matthewlaujh/the-sun/kicad/layout-dxf/sun-assembly-with-mounts-preview.png

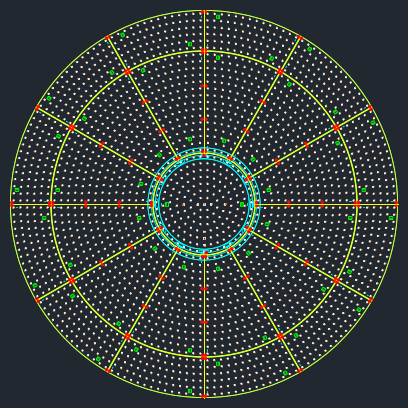
kicad/layout-dxf/sun-assembly-with-mounts-preview.png
