matthewlaujh/the-sun/sun-pcb-kicad-pack/docs/electrical-requirements.md

# Electrical requirements

Project: LED sun, Ø1773 mm disc · concentric rings, 12 wedges + centre disc · SK6812 RGBW @ 30 mm pitch · 2416 LEDs on 25 boards (3 unique designs) · PixLite E4-S Mk3.
Generated by Sun PCB Studio. Companion files: design.json (machine-readable), designs/*-outline.dxf, designs/*-placement.csv.

## System power

- 2416 × SK6812 RGBW @ 80 mA full white = **193 A @ 5 V (966 W)** worst case; typical content is far lower, but size for full white.
- PSU budget: ≥ 1160 W of 5 V supply (20 % headroom), e.g. 4× 300 W-class 5 V units, chassis-mounted behind the disc, short feeders.
- Distribution: one fused feeder per board power feed (blade fuse, rate ≈ 1.25× feed load, ≤ 10 A). 16 AWG per 10 A feeder max ~1 m.
- All GNDs common: PSU V− bus ↔ every board ↔ controller GND (PixLite outputs reference GND).

## Per-design current & copper (2-layer, 2 oz outer)

| Design | LEDs | Full-white | Feeds (≤10 A) | Min bus width per rail* |
|---|---|---|---|---|
| A | 172 | 13.8 A | 2 | 2.2 mm |
| B | 109 | 8.7 A | 1 | 1.2 mm |
| C | 78 | 6.2 A | 1 | 0.7 mm |

*IPC-2221 external, 10 °C rise, fed both ends. **Don't route power as traces — pour it**: V+ pour and GND pour covering the wire side (split roughly half/half or V+ pour + GND on LED side under the serpentine), stitched with vias at every LED. Wedge boards: run the pours as arcs following the LED rings; feed at the outer edge.

- Voltage-drop target: ≤ 0.15 V board-internal at full white (LEDs dim/redshift below ~4.5 V). With full-face pours this is comfortably met; verify worst path in the wedge tips.
- Data: 800 kHz single-ended; impedance uncontrolled. Keep LED-to-LED hops direct (serpentine per routing SVG), 100 Ω series at each board entry, pair with GND between boards.
- Frame budget: worst output chain 38.7 fps at 745 px/output cap (target 33.2).
- Thermal: 966 W over 2.5 m² is fine in open air at typical content; sustained full white pushes LED junctions — cap master brightness at ~60 % in the controller unless the show needs more.
