matthewlaujh/the-sun/sun-led-design-pack-test01/designs/design-C-drills.csv

Hole | Kind | Dia_mm | PosX_mm | PosY_mm | GlobalX_mm | GlobalY_mm
H1 | seam | 3.2 | -9.80 | 160.04 | 5.25 | 764.98
H2 | seam | 3.2 | 362.89 | 60.18 | 377.94 | 665.12
H3 | seam | 3.2 | 44.24 | 72.72 | 59.29 | 677.66
H4 | seam | 3.2 | 161.01 | 52.13 | 176.06 | 657.07
H5 | seam | 3.2 | 272.43 | 11.57 | 287.49 | 616.52
H6 | ring | 3.2 | 40.52 | 242.99 | 55.58 | 847.93
H7 | ring | 3.2 | 150.73 | 228.48 | 165.78 | 833.42
H8 | ring | 3.2 | 258.09 | 199.71 | 273.14 | 804.65
H9 | ring | 3.2 | 360.78 | 157.18 | 375.83 | 762.12
