matthewlaujh/the-sun/sun-pcb-kicad-pack/layout.png

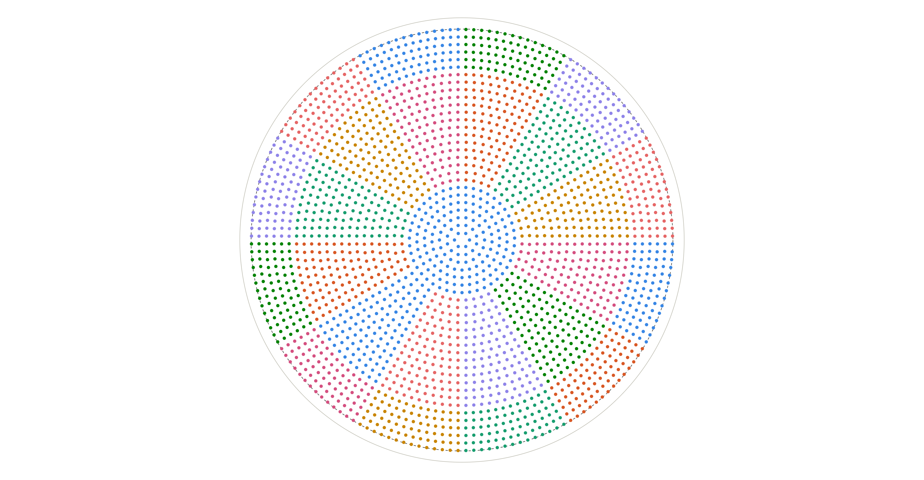
sun-pcb-kicad-pack/layout.png
