matthewlaujh/the-sun/sun-pcb-kicad-pack/docs/component-requirements.md

# Component requirements (BOM)

Project: LED sun, Ø1773 mm disc · concentric rings, 12 wedges + centre disc · SK6812 RGBW @ 30 mm pitch · 2416 LEDs on 25 boards (3 unique designs) · PixLite E4-S Mk3.
Generated by Sun PCB Studio. Companion files: design.json (machine-readable), designs/*-outline.dxf, designs/*-placement.csv.

## Per-design quantities (per single board)

| Design | Kind | Boards | LEDs | 100nF caps | R series | J_DIN+J_DOUT | Power feeds |
|---|---|---|---|---|---|---|---|
| A | disc | 1 | 172 | 172 | 1 | 1 | 2 |
| B | wedge | 12 | 109 | 109 | 1 | 1 | 1 |
| C | wedge | 12 | 78 | 78 | 1 | 1 | 1 |

## Line items

1. **LED — SK6812RGBW-NW (OPSCO)**, LCSC **C5160656**. RGBW 5050, natural-white W — pick -WW/-CW variant to taste and verify JLCPCB stock/loading fee. Total 2416 + ≥3 % reflow/rework spare → order ≈ 2500. Extended part (one-time loading fee per design).
2. **Vin cap — Samsung CL10B104KB8NNNC 100 nF 50 V X7R 0603**, LCSC **C1591** (JLCPCB basic part). Total 2416 + spare.
3. **Series data resistor** — 100 Ω 1 % 0603 (any basic part, e.g. LCSC C22775 class). 1 per board → 25.
4. **Data connectors** — JST XH 3-pin (B3B-XH-A top/side entry, THT, wire side) or JST SM pigtails; 2 per board (DIN+DOUT) → 50. THT = hand-solder or JLCPCB standard assembly only; SMD alternative: JST SM03B-SRSS-TB.
5. **Power feed hardware** — 26 feeds total: XT30PW-M right-angle (THT) or bare M4 ring-lug pad pairs (zero-cost option: plated pads + screw/nut). Bulk cap per feed: 470–1000 µF ≥ 6.3 V low-ESR (e.g. polymer). 26× cap.
6. **Distributed bulk** — 22–47 µF 6.3 V+ ceramic/polymer, ~1 per 30 LEDs → ≈ 81 total.

## Assembly notes (JLCPCB)

- Single-side SMT assembly (top = LED side): LEDs + 100 nF caps + series R. Wire-side parts (connectors, bulk caps) are THT/hand-solder — or flip to standard double-side assembly if you want them placed too.
- SK6812 RGBW is moisture-sensitive (MSL); JLCPCB bakes automatically — no action.
- Confirm the LED part's PCBA process (economic vs standard) on its JLCPCB page before committing the panel size.
- Mounting hardware: NONE on these boards by design (added in a later revision).
