matthewlaujh/the-sun/kicad/layout-dxf/sun-assembly-with-mounts.dxf

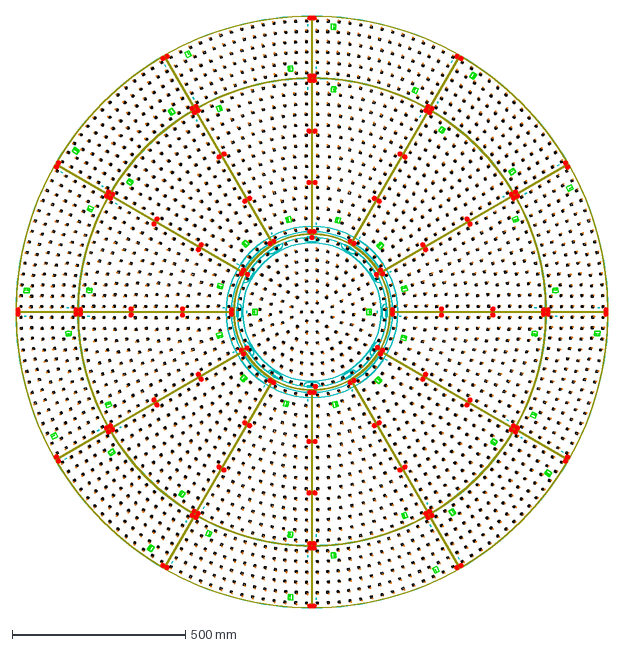
[picture p3: CAD file, 2026-09-03]
kicad/layout-dxf/sun-assembly-with-mounts.dxf
1708.0 x 1708.0 mm
