matthewlaujh/the-sun/kicad/layout-dxf/sun-assembly.dxf

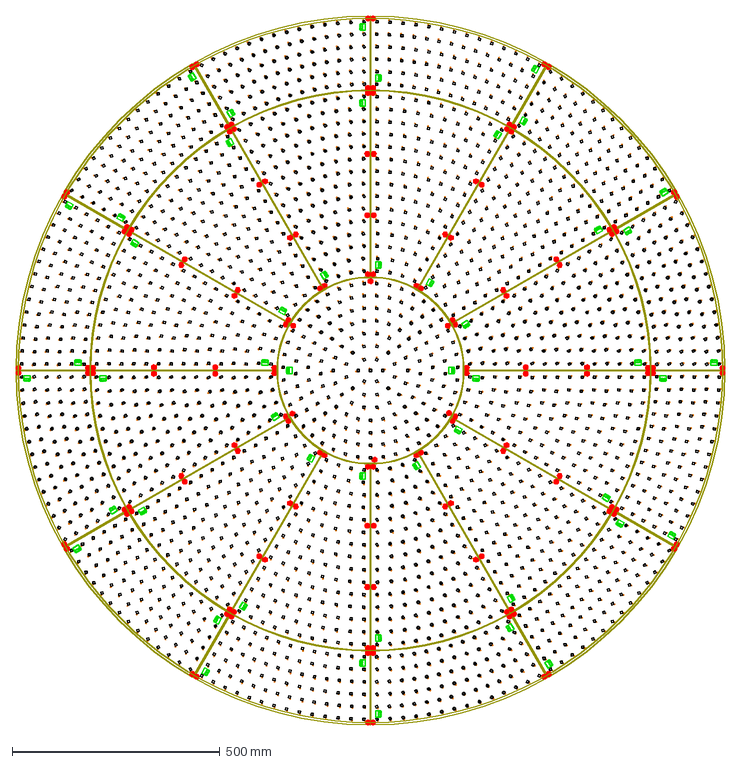
[picture p4: CAD file, 2026-09-03]
kicad/layout-dxf/sun-assembly.dxf
1708.0 x 1708.0 mm
