matthewlaujh/the-sun/sun-pcb-kicad-pack/designs/design-B-outline.dxf

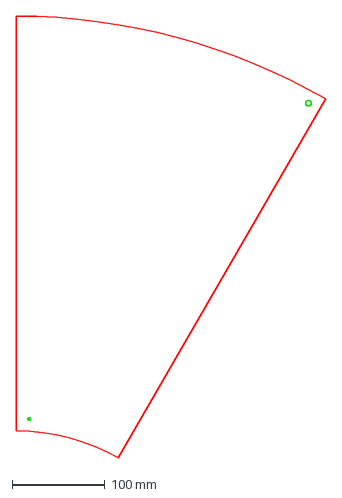
[picture p5: CAD file, 2026-08-16]
sun-pcb-kicad-pack/designs/design-B-outline.dxf
332.8 x 475.4 mm
