matthewlaujh/the-sun/sun-pcb-kicad-pack/designs/design-C-outline.dxf

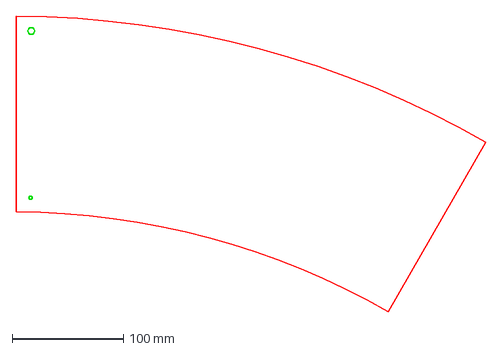
[picture p6: CAD file, 2026-08-16]
sun-pcb-kicad-pack/designs/design-C-outline.dxf
422.8 x 265.7 mm
