matthewlaujh/the-sun/sun-pcb-kicad-pack/designs/design-A-outline.dxf

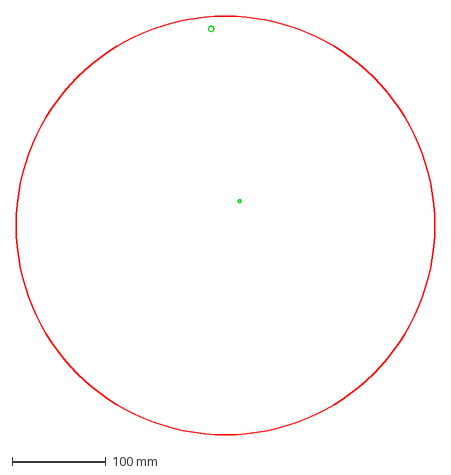
[picture p7: CAD file, 2026-08-16]
sun-pcb-kicad-pack/designs/design-A-outline.dxf
446.0 x 446.0 mm
