matthewlaujh/the-sun/(list of files, cad)

Other CAD files:
kicad/layout-dxf/sun-final-with-mounts.dxf
kicad/layout-dxf/sun-B-layout.dxf
kicad/layout-dxf/sun-C-layout.dxf
kicad/layout-dxf/sun-A-layout.dxf
