matthewlaujh/the-sun/kicad/layout-dxf/sun-assembly-preview.png

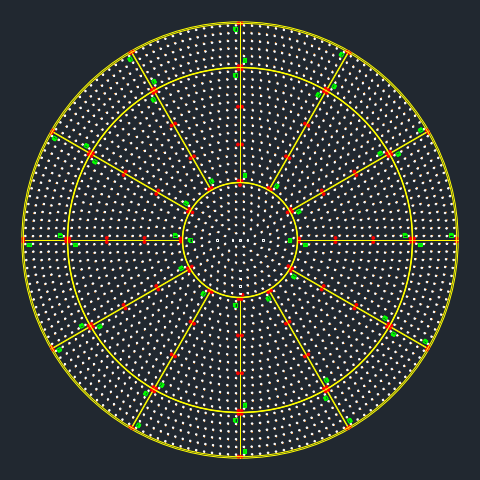
kicad/layout-dxf/sun-assembly-preview.png
