matthewlaujh/the-sun/sun-led-design-pack-test01/skeleton-members.csv

Member | Type | Role | Length_mm | x1_mm | y1_mm | x2_mm | y2_mm | Radius_mm | Start_deg | End_deg
1 | straight | under seam | 380.5 | -0.0 | 655.2 | -0.0 | 274.7
2 | straight | under seam | 380.5 | 0.0 | -274.7 | 0.0 | -655.2
3 | straight | under seam | 380.5 | 327.6 | 567.4 | 137.4 | 237.9
4 | straight | under seam | 380.5 | -137.4 | -237.9 | -327.6 | -567.4
5 | straight | under seam | 380.5 | 567.4 | 327.6 | 237.9 | 137.4
6 | straight | under seam | 380.5 | -237.9 | -137.4 | -567.4 | -327.6
7 | straight | under seam | 380.5 | 274.7 | 0.0 | 655.2 | 0.0
8 | straight | under seam | 380.5 | -567.4 | 327.6 | -237.9 | 137.4
9 | straight | under seam | 380.5 | 237.9 | -137.4 | 567.4 | -327.6
10 | straight | under seam | 380.5 | -327.6 | 567.4 | -137.4 | 237.9
11 | straight | under seam | 380.5 | 137.4 | -237.9 | 327.6 | -567.4
12 | straight | under seam | 380.5 | -274.7 | -0.0 | -655.2 | -0.0
13 | curved | under seam | 1107.8 |  |  |  |  | 764.0 | -151.16 | -68.08
14 | curved | under seam | 1107.8 |  |  |  |  | 764.0 | -68.08 | 15.00
15 | curved | under seam | 1107.8 |  |  |  |  | 764.0 | 15.00 | 98.08
16 | curved | under seam | 1107.8 |  |  |  |  | 764.0 | 98.08 | 181.16
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
