matthewlaujh/the-sun/sun-led-design-pack-test01/standoffs.csv

Standoff | Part | PCB | Design | Kind | x_mm | y_mm | Radius_mm | Angle_deg
1 | C2916368 | 13 | B | seam | -5.2 | 285.0 | 285.0 | 91.06
2 | C2916368 | 2 | B | seam | 5.2 | 285.0 | 285.0 | 88.94
3 | C2916368 | 2 | B | seam | 137.9 | 249.4 | 285.0 | 61.06
4 | C2916368 | 3 | B | seam | 147.0 | 244.2 | 285.0 | 58.94
5 | C2916368 | 3 | B | seam | 244.2 | 147.0 | 285.0 | 31.06
6 | C2916368 | 4 | B | seam | 249.4 | 137.9 | 285.0 | 28.94
7 | C2916368 | 4 | B | seam | 285.0 | 5.2 | 285.0 | 1.06
8 | C2916368 | 5 | B | seam | 285.0 | -5.2 | 285.0 | -1.06
9 | C2916368 | 5 | B | seam | 249.4 | -137.9 | 285.0 | -28.94
10 | C2916368 | 6 | B | seam | 244.2 | -147.0 | 285.0 | -31.06
11 | C2916368 | 6 | B | seam | 147.0 | -244.2 | 285.0 | -58.94
12 | C2916368 | 7 | B | seam | 137.9 | -249.4 | 285.0 | -61.06
13 | C2916368 | 7 | B | seam | 5.2 | -285.0 | 285.0 | -88.94
14 | C2916368 | 8 | B | seam | -5.2 | -285.0 | 285.0 | -91.06
15 | C2916368 | 8 | B | seam | -137.9 | -249.4 | 285.0 | -118.94
16 | C2916368 | 9 | B | seam | -147.0 | -244.2 | 285.0 | -121.06
17 | C2916368 | 9 | B | seam | -244.2 | -147.0 | 285.0 | -148.94
18 | C2916368 | 10 | B | seam | -249.4 | -137.9 | 285.0 | -151.06
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
