matthewlaujh/the-sun/sun-led-design-pack-test01/layout.png

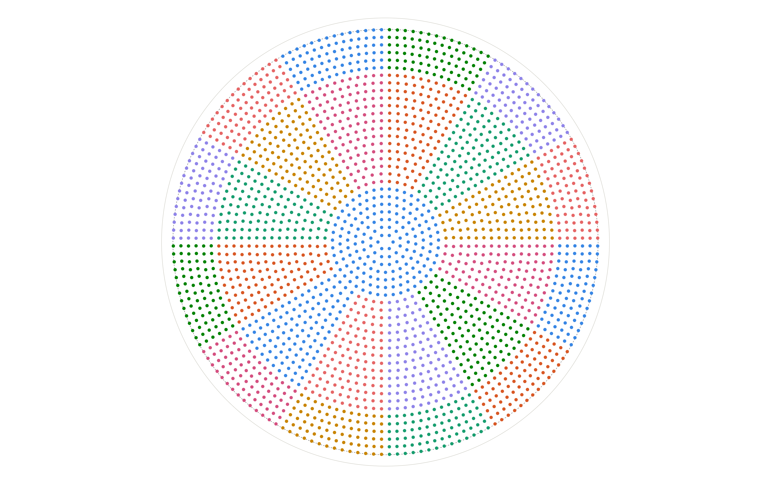
sun-led-design-pack-test01/layout.png
