matthewlaujh/the-sun/kicad/sun-A/sun-A.kicad_pcb

## KiCad design kicad/sun-A/sun-A.kicad_pcb (2026-10-01)

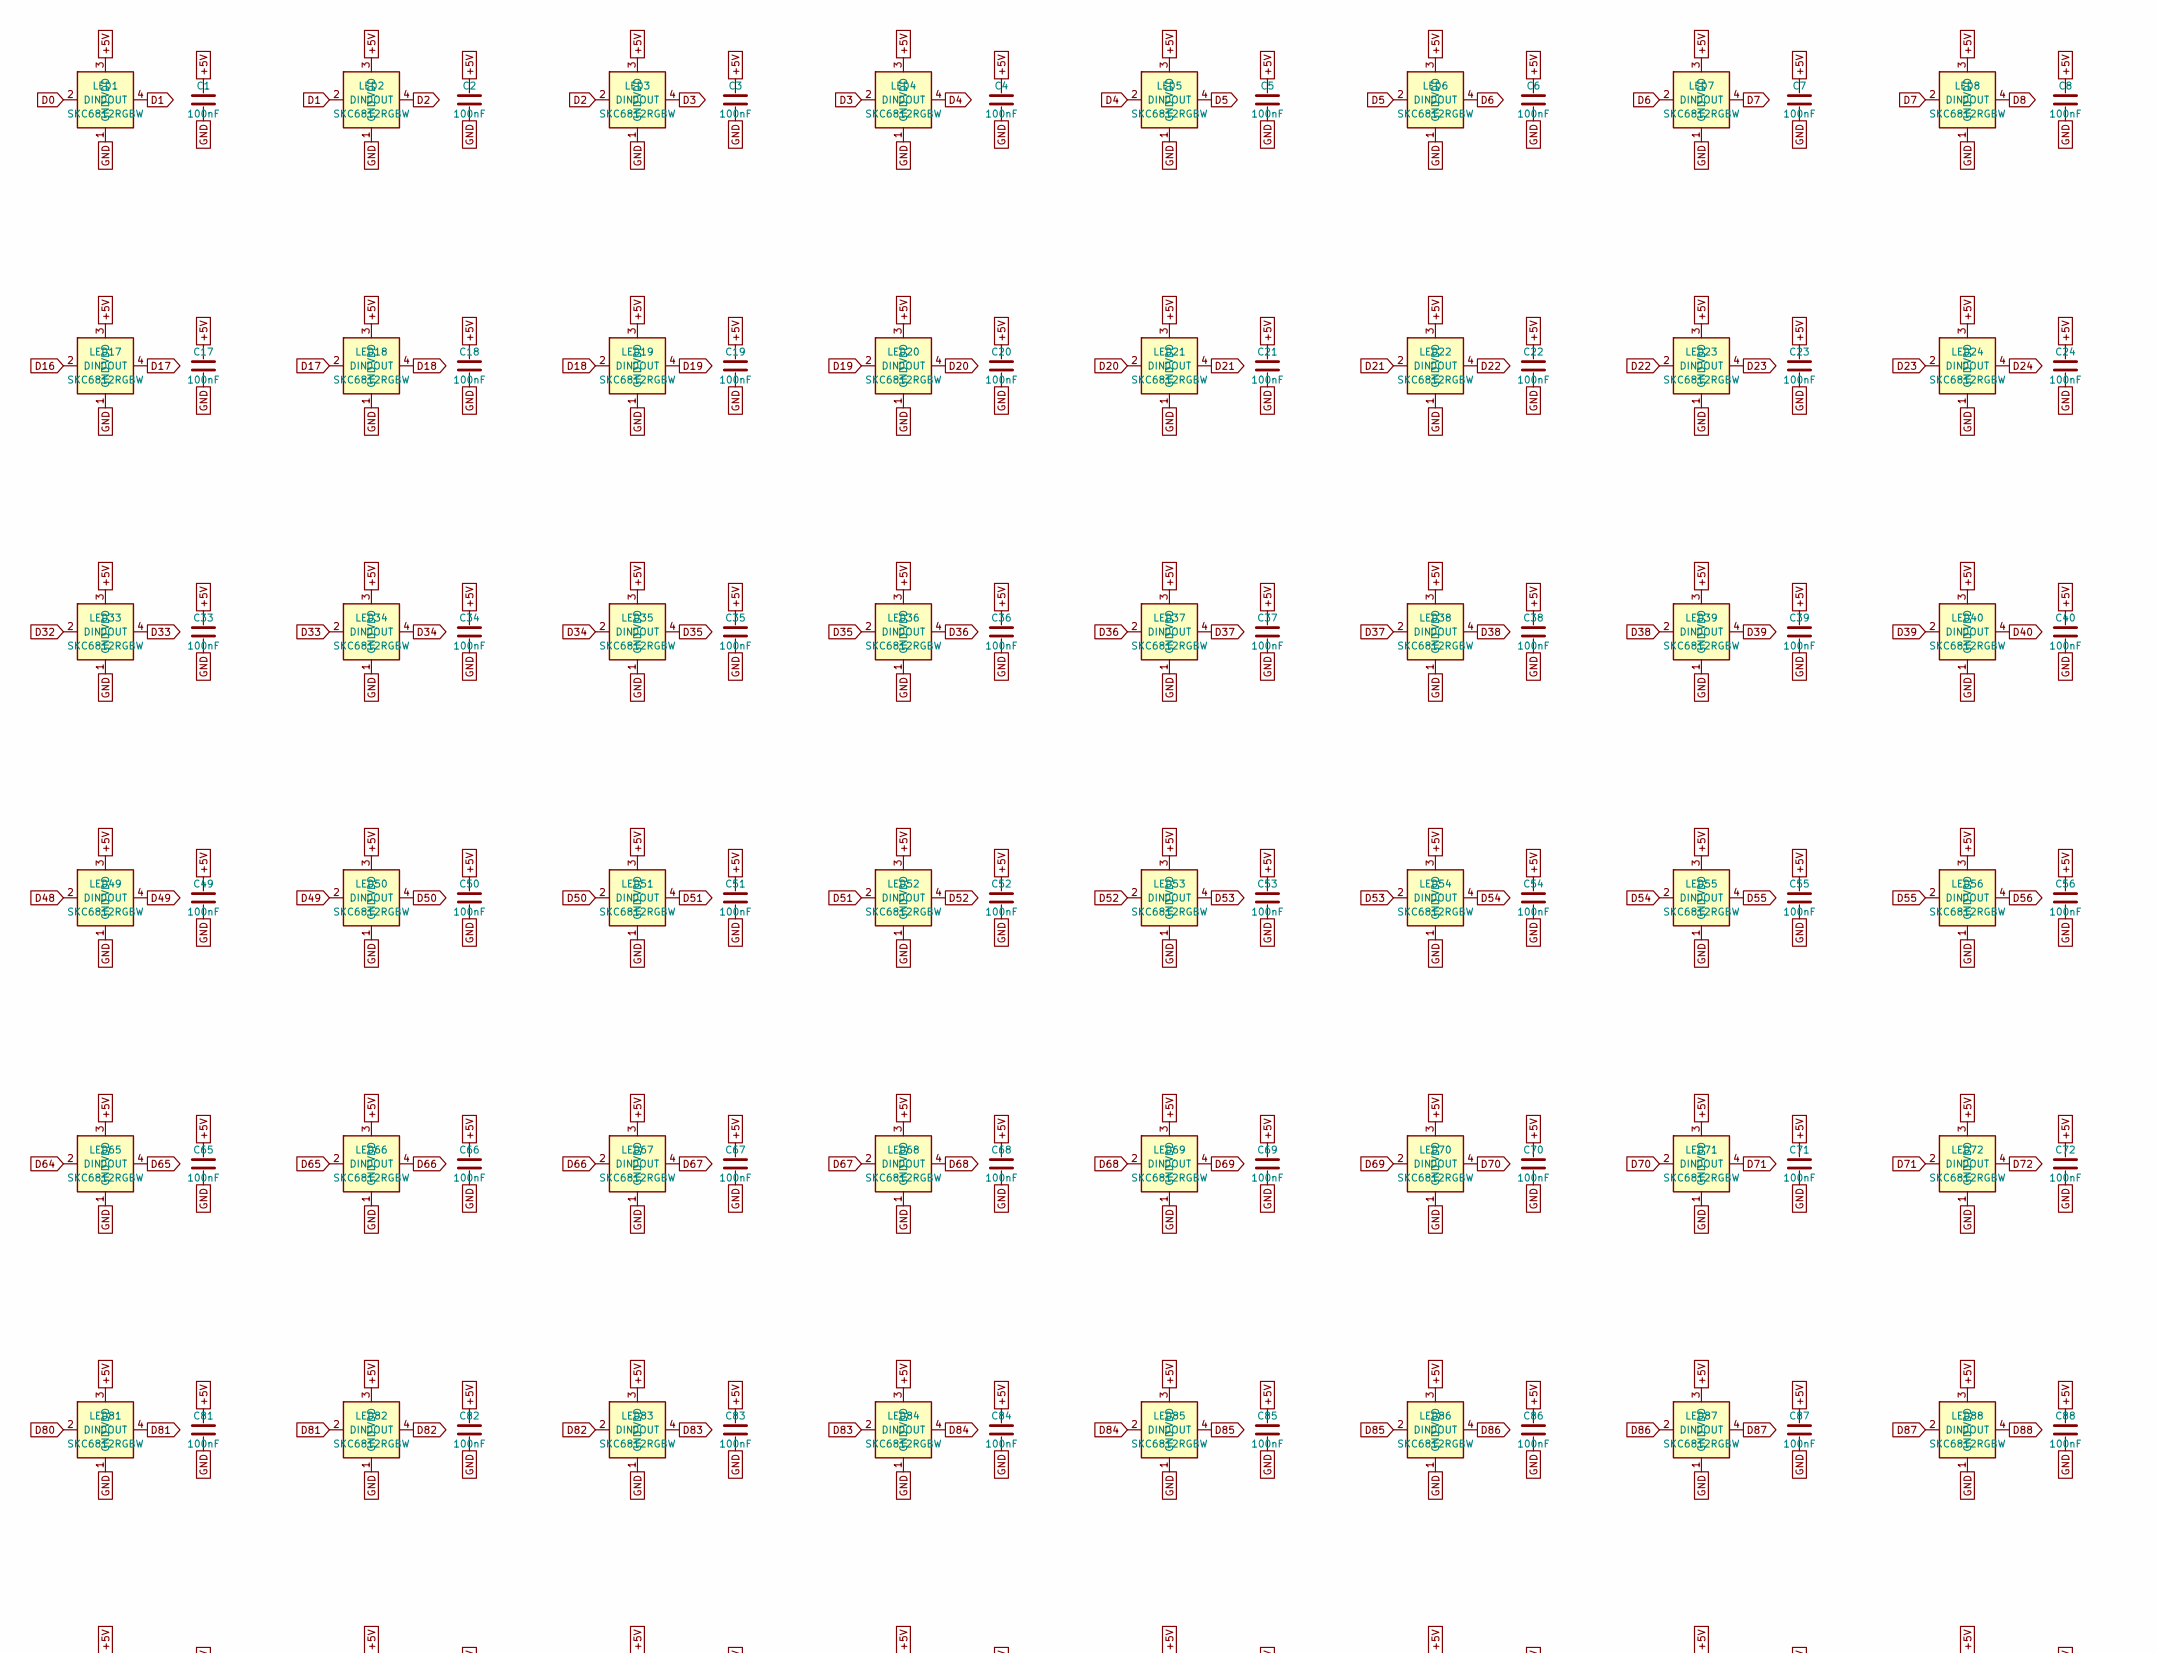
[picture p10: schematic sun-A.kicad_sch, the sun - design A, part in row 1, column 1]

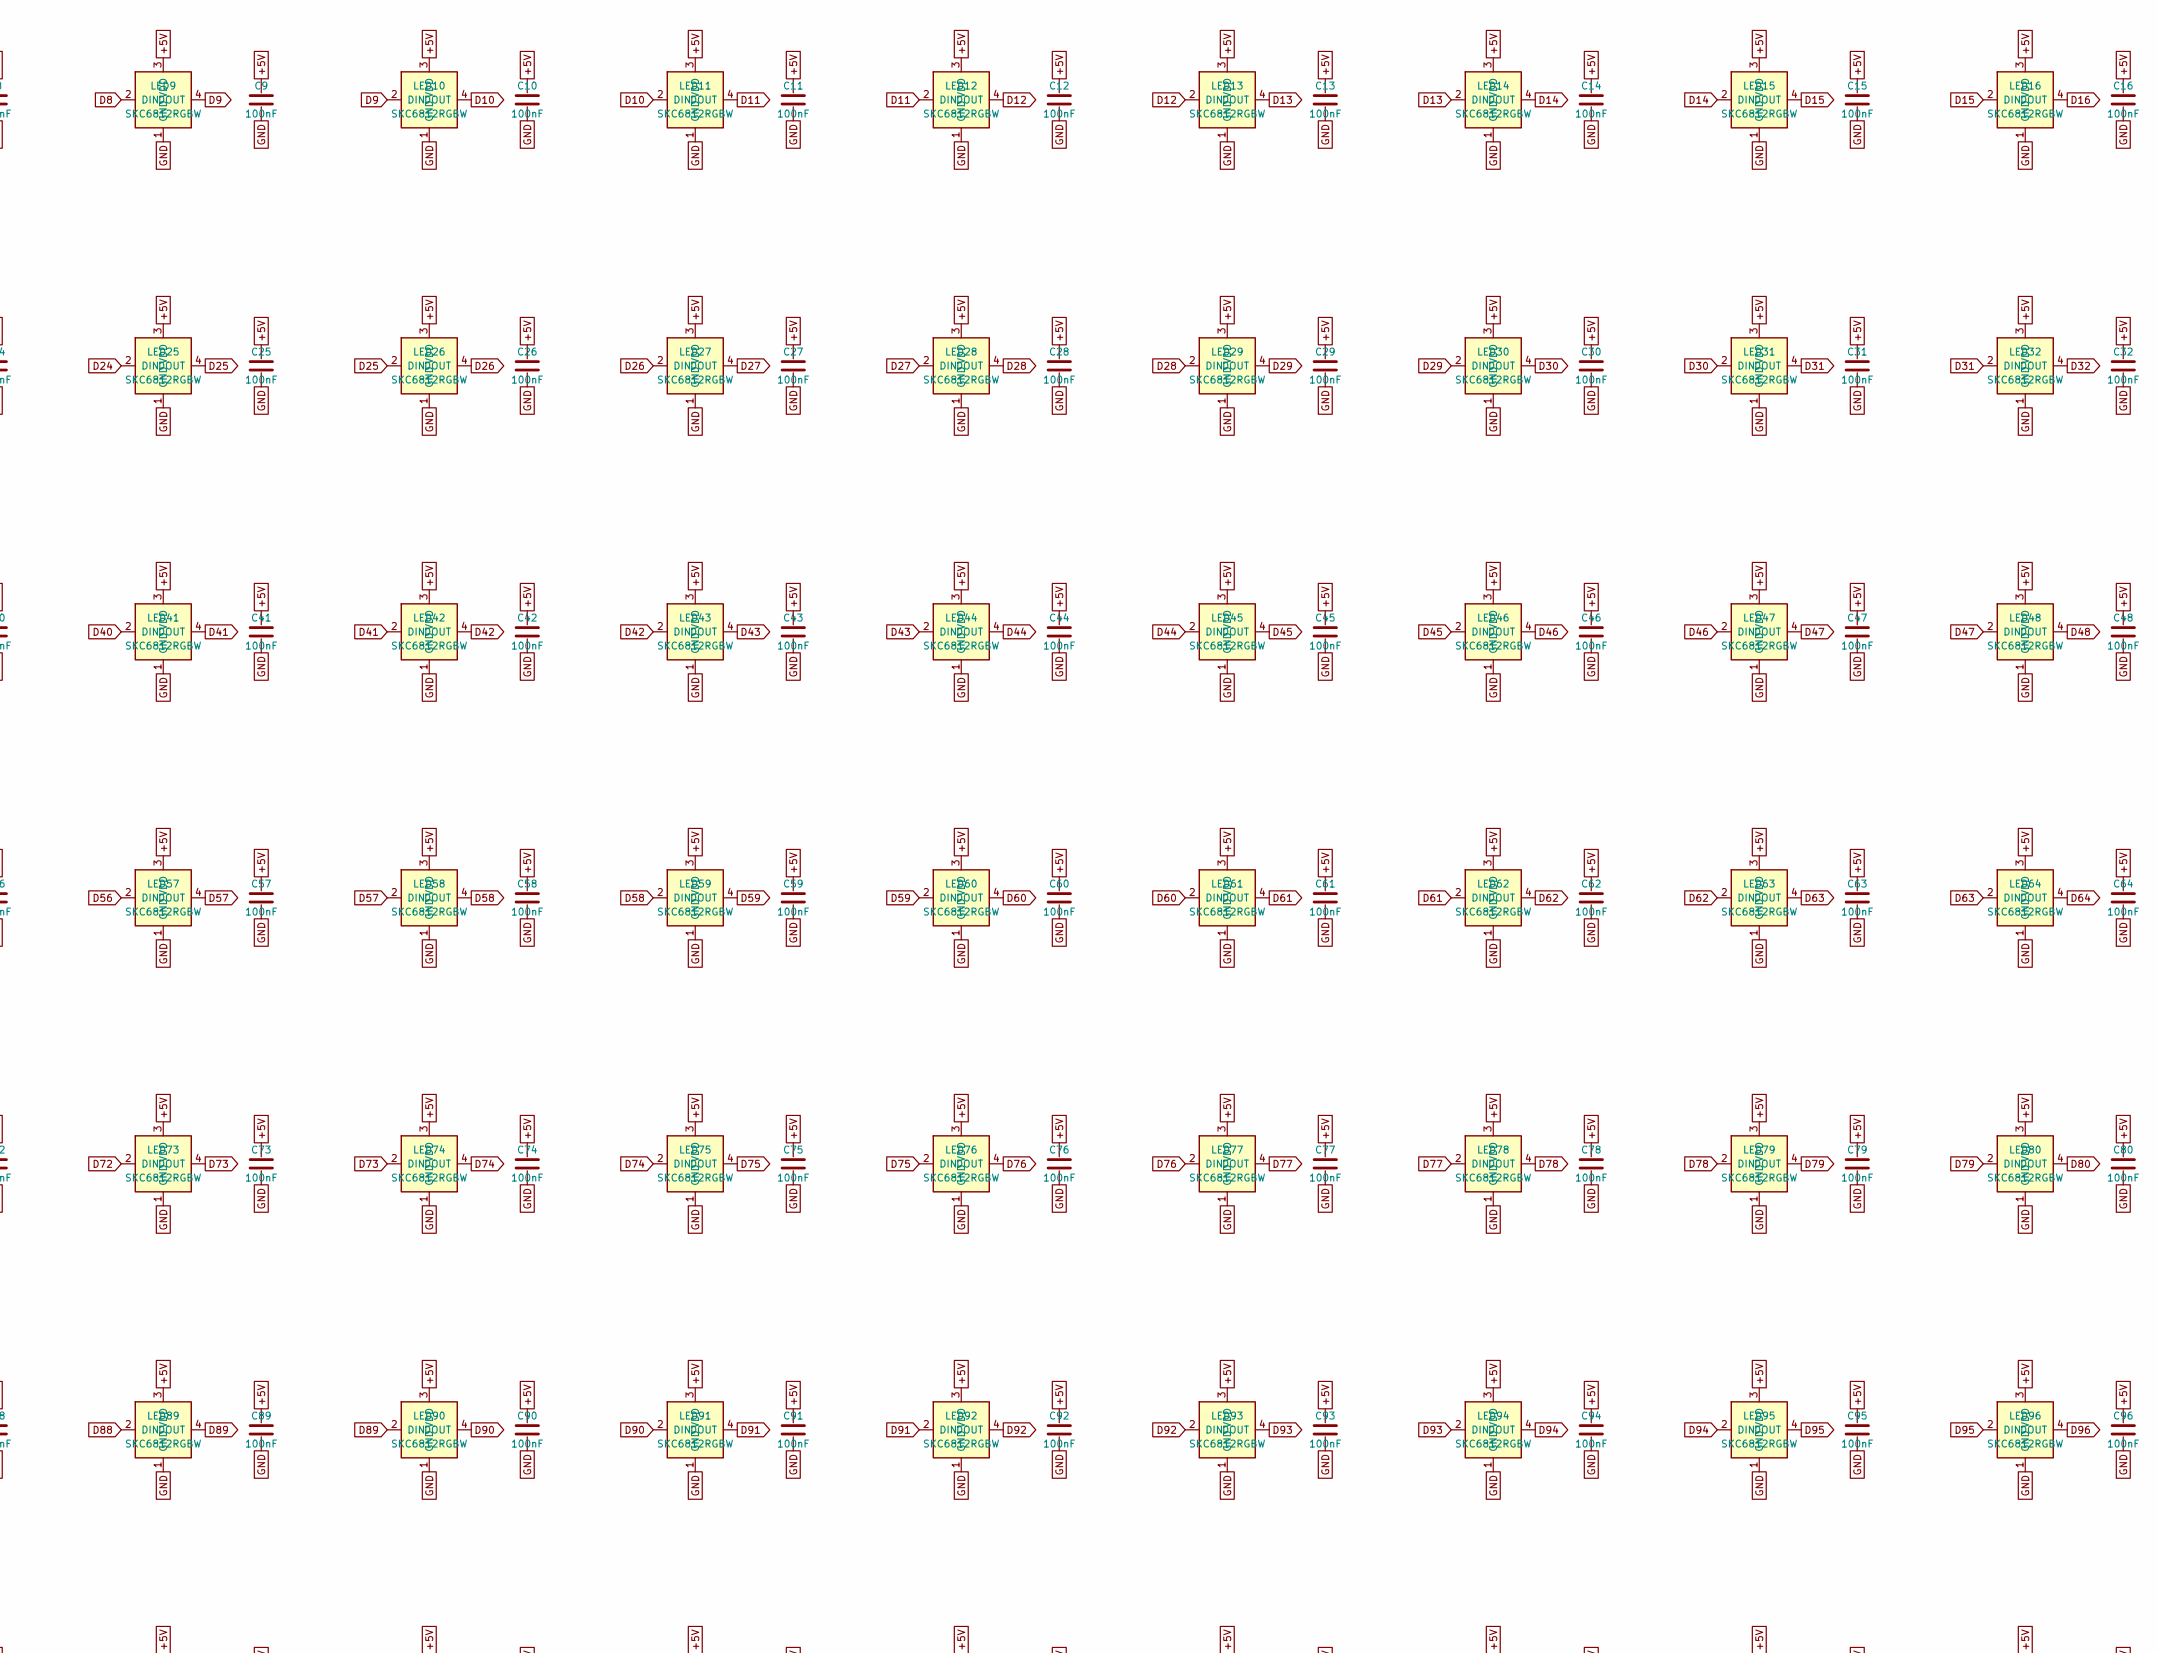
[picture p11: schematic sun-A.kicad_sch, the sun - design A, part in row 1, column 2]

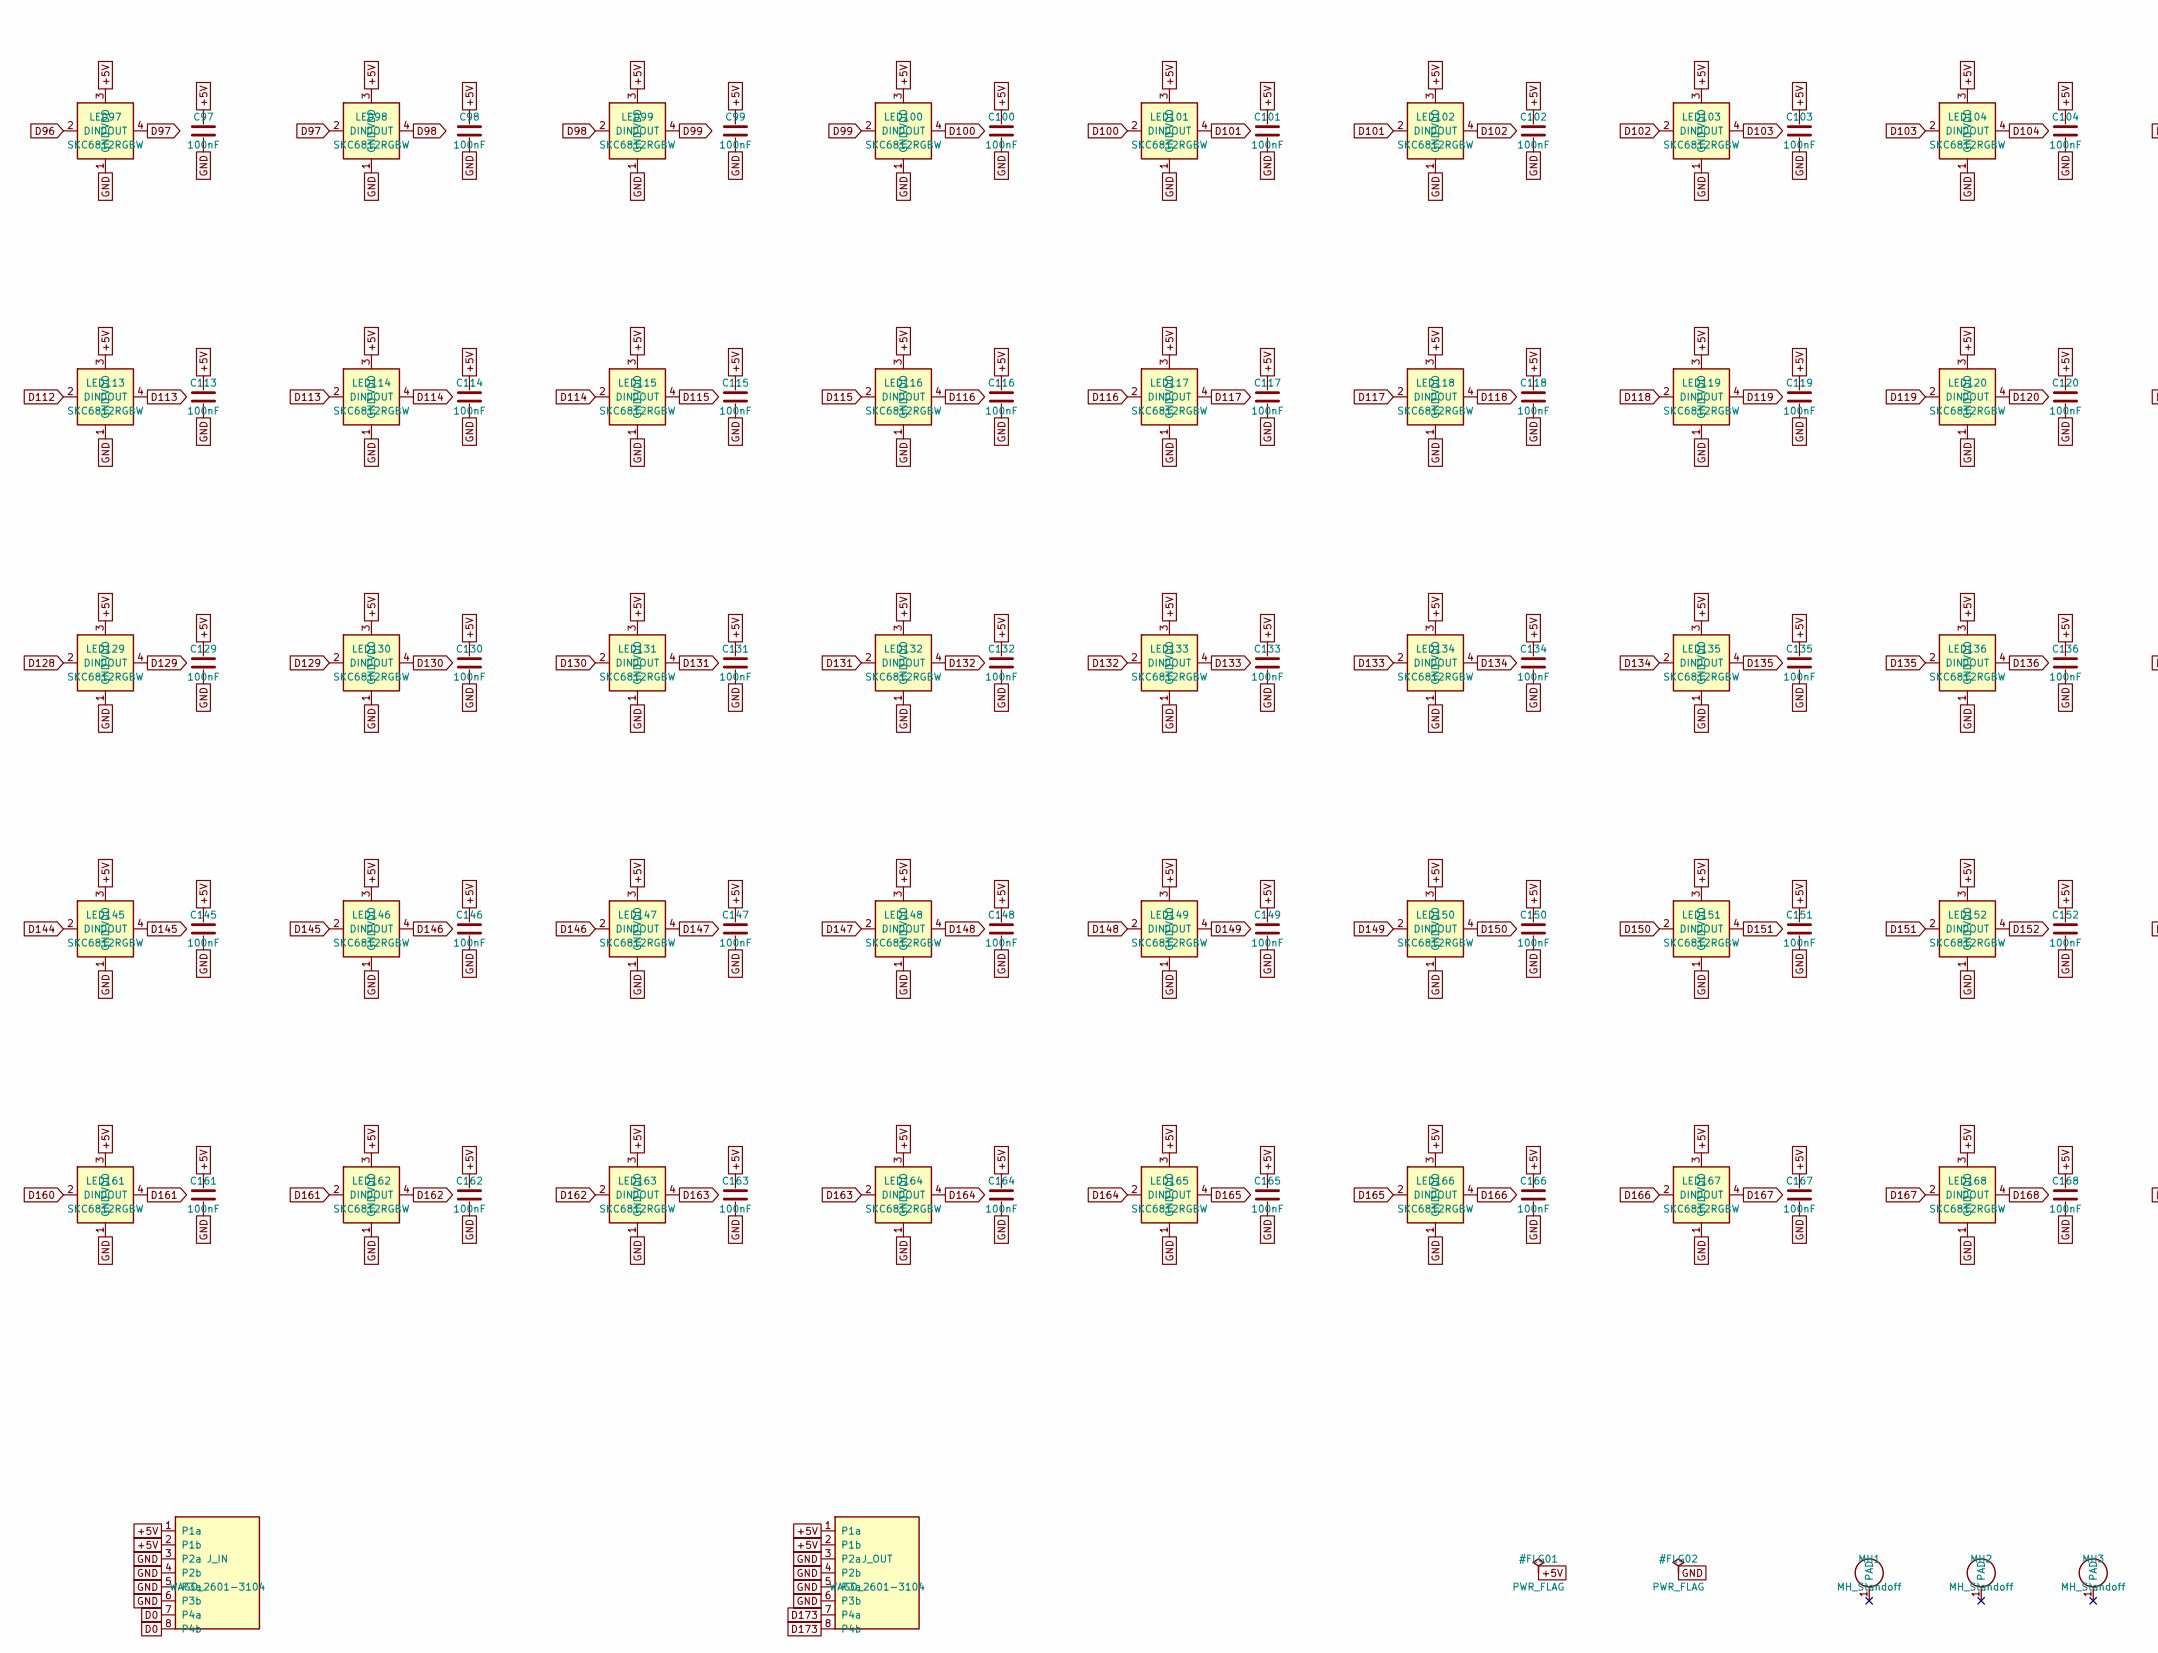
[picture p12: schematic sun-A.kicad_sch, the sun - design A, part in row 2, column 1]

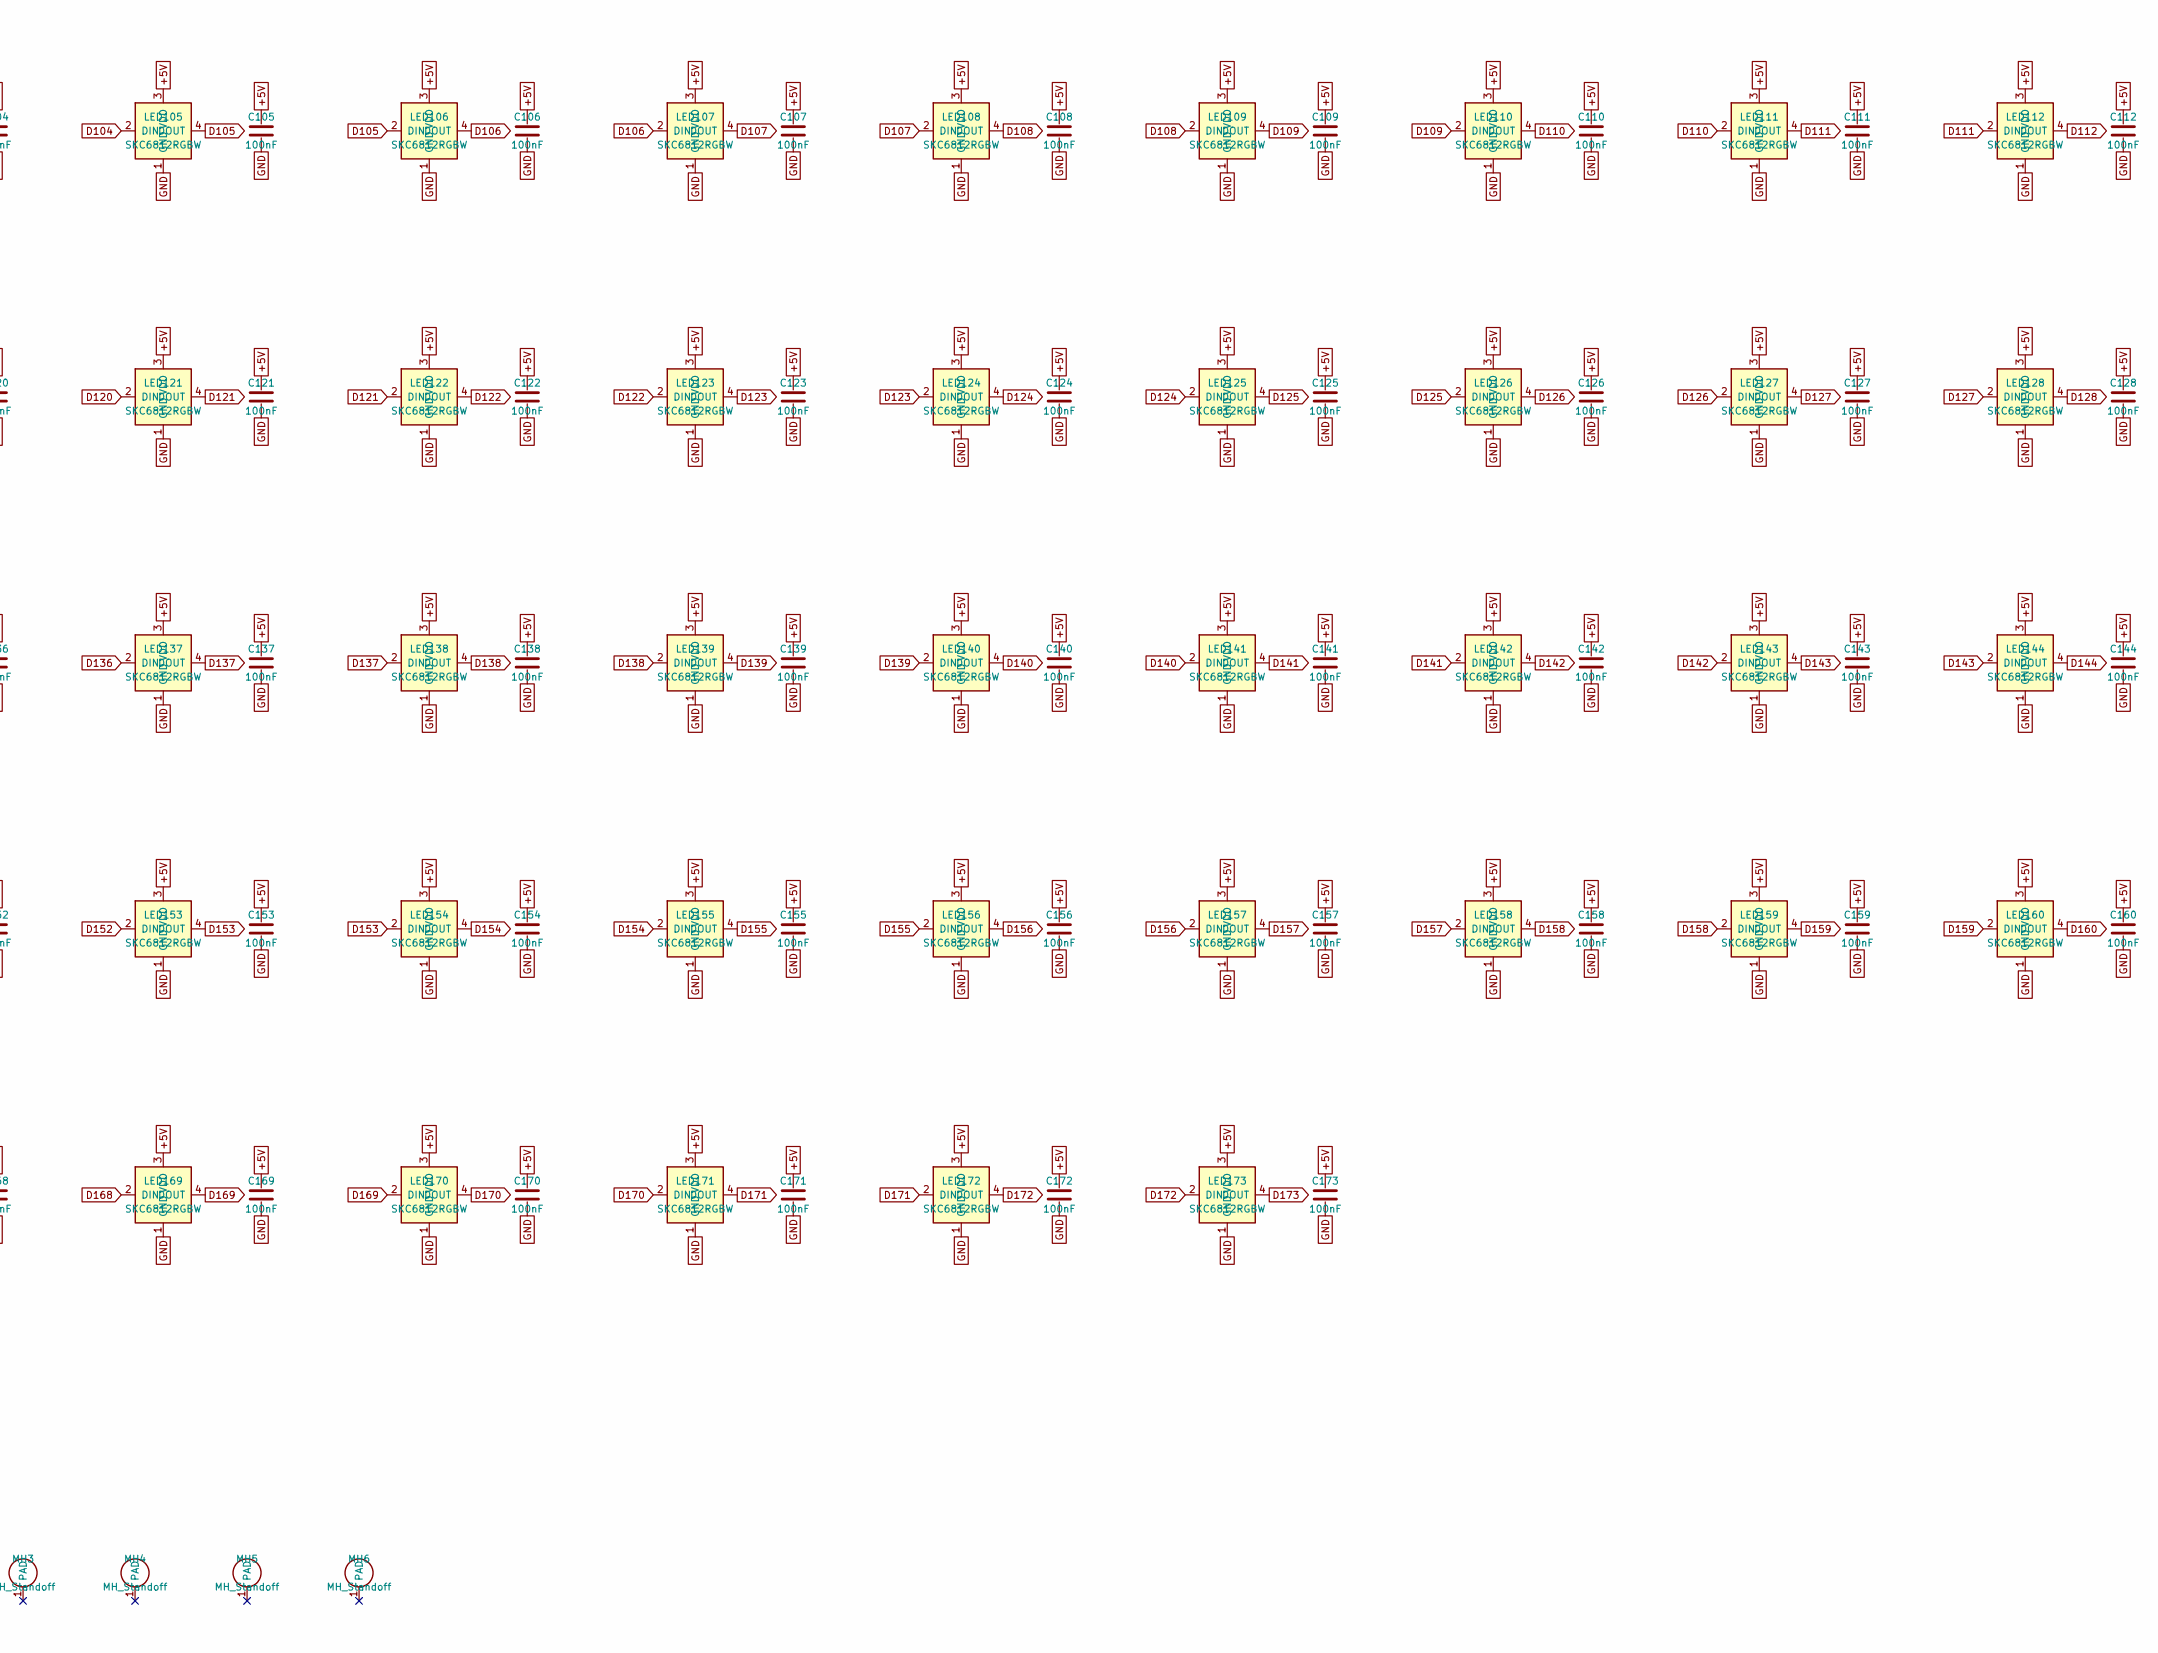
[picture p13: schematic sun-A.kicad_sch, the sun - design A, part in row 2, column 2]

Parts:
C1, C2, C3, C4, C5, C6, C7, C8, C9, C10, C11, C12, C13, C14, C15, C16, C17, C18, C19, C20, C21, C22, C23, C24, C25, C26, C27, C28, C29, C30, C31, C32, C33, C34, C35, C36, C37, C38, C39, C40, C41, C42, C43, C44, C45, C46, C47, C48, C49, C50, C51, C52, C53, C54, C55, C56, C57, C58, C59, C60, C61, C62, C63, C64, C65, C66, C67, C68, C69, C70, C71, C72, C73, C74, C75, C76, C77, C78, C79, C80, C81, C82, C83, C84, C85, C86, C87, C88, C89, C90, C91, C92, C93, C94, C95, C96, C97, C98, C99, C100, C101, C102, C103, C104, C105, C106, C107, C108, C109, C110, C111, C112, C113, C114, C115, C116, C117, C118, C119, C120, C121, C122, C123, C124, C125, C126, C127, C128, C129, C130, C131, C132, C133, C134, C135, C136, C137, C138, C139, C140, C141, C142, C143, C144, C145, C146, C147, C148, C149, C150, C151, C152, C153, C154, C155, C156, C157, C158, C159, C160, C161, C162, C163, C164, C165, C166, C167, C168, C169, C170, C171, C172, C173: 100nF; C_0603_1608Metric; LCSC C1591
J_IN: WAGO_2601-3104; WAGO_2601-3104_THT
J_OUT: WAGO_2601-3104; WAGO_2601-3104_THT
LED1, LED2, LED3, LED4, LED5, LED6, LED7, LED8, LED9, LED10, LED11, LED12, LED13, LED14, LED15, LED16, LED17, LED18, LED19, LED20, LED21, LED22, LED23, LED24, LED25, LED26, LED27, LED28, LED29, LED30, LED31, LED32, LED33, LED34, LED35, LED36, LED37, LED38, LED39, LED40, LED41, LED42, LED43, LED44, LED45, LED46, LED47, LED48, LED49, LED50, LED51, LED52, LED53, LED54, LED55, LED56, LED57, LED58, LED59, LED60, LED61, LED62, LED63, LED64, LED65, LED66, LED67, LED68, LED69, LED70, LED71, LED72, LED73, LED74, LED75, LED76, LED77, LED78, LED79, LED80, LED81, LED82, LED83, LED84, LED85, LED86, LED87, LED88, LED89, LED90, LED91, LED92, LED93, LED94, LED95, LED96, LED97, LED98, LED99, LED100, LED101, LED102, LED103, LED104, LED105, LED106, LED107, LED108, LED109, LED110, LED111, LED112, LED113, LED114, LED115, LED116, LED117, LED118, LED119, LED120, LED121, LED122, LED123, LED124, LED125, LED126, LED127, LED128, LED129, LED130, LED131, LED132, LED133, LED134, LED135, LED136, LED137, LED138, LED139, LED140, LED141, LED142, LED143, LED144, LED145, LED146, LED147, LED148, LED149, LED150, LED151, LED152, LED153, LED154, LED155, LED156, LED157, LED158, LED159, LED160, LED161, LED162, LED163, LED164, LED165, LED166, LED167, LED168, LED169, LED170, LED171, LED172, LED173: SKC6812RGBW; LED_SKC6812RGBW_5050; LCSC C5348912
MH1, MH2, MH3, MH4, MH5, MH6: MH_Standoff; MH_M3_SMT_Standoff_BZXC; LCSC C20617225 (3mm; 30mm variant TBC)

Connections:
+5V: C1.1, C2.1, C3.1, C4.1, C5.1, C6.1, C7.1, C8.1, C9.1, C10.1, C11.1, C12.1, C13.1, C14.1, C15.1, C16.1, C17.1, C18.1, C19.1, C20.1, C21.1, C22.1, C23.1, C24.1, C25.1, C26.1, C27.1, C28.1, C29.1, C30.1, C31.1, C32.1, C33.1, C34.1, C35.1, C36.1, C37.1, C38.1, C39.1, C40.1, C41.1, C42.1, C43.1, C44.1, C45.1, C46.1, C47.1, C48.1, C49.1, C50.1, C51.1, C52.1, C53.1, C54.1, C55.1, C56.1, C57.1, C58.1, C59.1, C60.1, C61.1, C62.1, C63.1, C64.1, C65.1, C66.1, C67.1, C68.1, C69.1, C70.1, C71.1, C72.1, C73.1, C74.1, C75.1, C76.1, C77.1, C78.1, C79.1, C80.1, C81.1, C82.1, C83.1, C84.1, C85.1, C86.1, C87.1, C88.1, C89.1, C90.1, C91.1, C92.1, C93.1, C94.1, C95.1, C96.1, C97.1, C98.1, C99.1, C100.1, C101.1, C102.1, C103.1, C104.1, C105.1, C106.1, C107.1, C108.1, C109.1, C110.1, C111.1, C112.1, C113.1, C114.1, C115.1, C116.1, C117.1, C118.1, C119.1, C120.1, C121.1, C122.1, C123.1, C124.1, C125.1, C126.1, C127.1, C128.1, C129.1, C130.1, C131.1, C132.1, C133.1, C134.1, C135.1, C136.1, C137.1, C138.1, C139.1, C140.1, C141.1, C142.1, C143.1, C144.1, C145.1, C146.1, C147.1, C148.1, C149.1, C150.1, C151.1, C152.1, C153.1, C154.1, C155.1, C156.1, C157.1, C158.1, C159.1, C160.1, C161.1, C162.1, C163.1, C164.1, C165.1, C166.1, C167.1, C168.1, C169.1, C170.1, C171.1, C172.1, C173.1, J_IN.1 (P1a), J_IN.2 (P1b), J_OUT.1 (P1a), J_OUT.2 (P1b), LED1.3 (VDD), LED2.3 (VDD), LED3.3 (VDD), LED4.3 (VDD), LED5.3 (VDD), LED6.3 (VDD), LED7.3 (VDD), LED8.3 (VDD), LED9.3 (VDD), LED10.3 (VDD), LED11.3 (VDD), LED12.3 (VDD), LED13.3 (VDD), LED14.3 (VDD), LED15.3 (VDD), LED16.3 (VDD), LED17.3 (VDD), LED18.3 (VDD), LED19.3 (VDD), LED20.3 (VDD), LED21.3 (VDD), LED22.3 (VDD), LED23.3 (VDD), LED24.3 (VDD), LED25.3 (VDD), LED26.3 (VDD), LED27.3 (VDD), LED28.3 (VDD), LED29.3 (VDD), LED30.3 (VDD), LED31.3 (VDD), LED32.3 (VDD), LED33.3 (VDD), LED34.3 (VDD), LED35.3 (VDD), LED36.3 (VDD), LED37.3 (VDD), LED38.3 (VDD), LED39.3 (VDD), LED40.3 (VDD), LED41.3 (VDD), LED42.3 (VDD), LED43.3 (VDD), LED44.3 (VDD), LED45.3 (VDD), LED46.3 (VDD), LED47.3 (VDD), LED48.3 (VDD), LED49.3 (VDD), LED50.3 (VDD), LED51.3 (VDD), LED52.3 (VDD), LED53.3 (VDD), LED54.3 (VDD), LED55.3 (VDD), LED56.3 (VDD), LED57.3 (VDD), LED58.3 (VDD), LED59.3 (VDD), LED60.3 (VDD), LED61.3 (VDD), LED62.3 (VDD), LED63.3 (VDD), LED64.3 (VDD), LED65.3 (VDD), LED66.3 (VDD), LED67.3 (VDD), LED68.3 (VDD), LED69.3 (VDD), LED70.3 (VDD), LED71.3 (VDD), LED72.3 (VDD), LED73.3 (VDD), LED74.3 (VDD), LED75.3 (VDD), LED76.3 (VDD), LED77.3 (VDD), LED78.3 (VDD), LED79.3 (VDD), LED80.3 (VDD), LED81.3 (VDD), LED82.3 (VDD), LED83.3 (VDD), LED84.3 (VDD), LED85.3 (VDD), LED86.3 (VDD), LED87.3 (VDD), LED88.3 (VDD), LED89.3 (VDD), LED90.3 (VDD), LED91.3 (VDD), LED92.3 (VDD), LED93.3 (VDD), LED94.3 (VDD), LED95.3 (VDD), LED96.3 (VDD), LED97.3 (VDD), LED98.3 (VDD), LED99.3 (VDD), LED100.3 (VDD), LED101.3 (VDD), LED102.3 (VDD), LED103.3 (VDD), LED104.3 (VDD), LED105.3 (VDD), LED106.3 (VDD), LED107.3 (VDD), LED108.3 (VDD), LED109.3 (VDD), LED110.3 (VDD), LED111.3 (VDD), LED112.3 (VDD), LED113.3 (VDD), LED114.3 (VDD), LED115.3 (VDD), LED116.3 (VDD), LED117.3 (VDD), LED118.3 (VDD), LED119.3 (VDD), LED120.3 (VDD), LED121.3 (VDD), LED122.3 (VDD), LED123.3 (VDD), LED124.3 (VDD), LED125.3 (VDD), LED126.3 (VDD), LED127.3 (VDD), LED128.3 (VDD), LED129.3 (VDD), LED130.3 (VDD), LED131.3 (VDD), LED132.3 (VDD), LED133.3 (VDD), LED134.3 (VDD), LED135.3 (VDD), LED136.3 (VDD), LED137.3 (VDD), LED138.3 (VDD), LED139.3 (VDD), LED140.3 (VDD), LED141.3 (VDD), LED142.3 (VDD), LED143.3 (VDD), LED144.3 (VDD), LED145.3 (VDD), LED146.3 (VDD), LED147.3 (VDD), LED148.3 (VDD), LED149.3 (VDD), LED150.3 (VDD), LED151.3 (VDD), LED152.3 (VDD), LED153.3 (VDD), LED154.3 (VDD), LED155.3 (VDD), LED156.3 (VDD), LED157.3 (VDD), LED158.3 (VDD), LED159.3 (VDD), LED160.3 (VDD), LED161.3 (VDD), LED162.3 (VDD), LED163.3 (VDD), LED164.3 (VDD), LED165.3 (VDD), LED166.3 (VDD), LED167.3 (VDD), LED168.3 (VDD), LED169.3 (VDD), LED170.3 (VDD), LED171.3 (VDD), LED172.3 (VDD), LED173.3 (VDD)
D0: J_IN.7 (P4a), J_IN.8 (P4b), LED1.2 (DIN)
D1: LED1.4 (DOUT), LED2.2 (DIN)
D2: LED2.4 (DOUT), LED3.2 (DIN)
D3: LED3.4 (DOUT), LED4.2 (DIN)
D4: LED4.4 (DOUT), LED5.2 (DIN)
D5: LED5.4 (DOUT), LED6.2 (DIN)
D6: LED6.4 (DOUT), LED7.2 (DIN)
D7: LED7.4 (DOUT), LED8.2 (DIN)
D8: LED8.4 (DOUT), LED9.2 (DIN)
D9: LED9.4 (DOUT), LED10.2 (DIN)
D10: LED10.4 (DOUT), LED11.2 (DIN)
D11: LED11.4 (DOUT), LED12.2 (DIN)
D12: LED12.4 (DOUT), LED13.2 (DIN)
D13: LED13.4 (DOUT), LED14.2 (DIN)
D14: LED14.4 (DOUT), LED15.2 (DIN)
D15: LED15.4 (DOUT), LED16.2 (DIN)
D16: LED16.4 (DOUT), LED17.2 (DIN)
D17: LED17.4 (DOUT), LED18.2 (DIN)
D18: LED18.4 (DOUT), LED19.2 (DIN)
D19: LED19.4 (DOUT), LED20.2 (DIN)
D20: LED20.4 (DOUT), LED21.2 (DIN)
D21: LED21.4 (DOUT), LED22.2 (DIN)
D22: LED22.4 (DOUT), LED23.2 (DIN)
D23: LED23.4 (DOUT), LED24.2 (DIN)
D24: LED24.4 (DOUT), LED25.2 (DIN)
D25: LED25.4 (DOUT), LED26.2 (DIN)
D26: LED26.4 (DOUT), LED27.2 (DIN)
D27: LED27.4 (DOUT), LED28.2 (DIN)
D28: LED28.4 (DOUT), LED29.2 (DIN)
D29: LED29.4 (DOUT), LED30.2 (DIN)
D30: LED30.4 (DOUT), LED31.2 (DIN)
D31: LED31.4 (DOUT), LED32.2 (DIN)
D32: LED32.4 (DOUT), LED33.2 (DIN)
D33: LED33.4 (DOUT), LED34.2 (DIN)
D34: LED34.4 (DOUT), LED35.2 (DIN)
D35: LED35.4 (DOUT), LED36.2 (DIN)
D36: LED36.4 (DOUT), LED37.2 (DIN)
D37: LED37.4 (DOUT), LED38.2 (DIN)
D38: LED38.4 (DOUT), LED39.2 (DIN)
D39: LED39.4 (DOUT), LED40.2 (DIN)
D40: LED40.4 (DOUT), LED41.2 (DIN)
D41: LED41.4 (DOUT), LED42.2 (DIN)
D42: LED42.4 (DOUT), LED43.2 (DIN)
D43: LED43.4 (DOUT), LED44.2 (DIN)
D44: LED44.4 (DOUT), LED45.2 (DIN)
D45: LED45.4 (DOUT), LED46.2 (DIN)
D46: LED46.4 (DOUT), LED47.2 (DIN)
D47: LED47.4 (DOUT), LED48.2 (DIN)
D48: LED48.4 (DOUT), LED49.2 (DIN)
D49: LED49.4 (DOUT), LED50.2 (DIN)
D50: LED50.4 (DOUT), LED51.2 (DIN)
D51: LED51.4 (DOUT), LED52.2 (DIN)
D52: LED52.4 (DOUT), LED53.2 (DIN)
D53: LED53.4 (DOUT), LED54.2 (DIN)
D54: LED54.4 (DOUT), LED55.2 (DIN)
D55: LED55.4 (DOUT), LED56.2 (DIN)
D56: LED56.4 (DOUT), LED57.2 (DIN)
D57: LED57.4 (DOUT), LED58.2 (DIN)
D58: LED58.4 (DOUT), LED59.2 (DIN)
D59: LED59.4 (DOUT), LED60.2 (DIN)
D60: LED60.4 (DOUT), LED61.2 (DIN)
D61: LED61.4 (DOUT), LED62.2 (DIN)
D62: LED62.4 (DOUT), LED63.2 (DIN)
D63: LED63.4 (DOUT), LED64.2 (DIN)
D64: LED64.4 (DOUT), LED65.2 (DIN)
D65: LED65.4 (DOUT), LED66.2 (DIN)
D66: LED66.4 (DOUT), LED67.2 (DIN)
D67: LED67.4 (DOUT), LED68.2 (DIN)
D68: LED68.4 (DOUT), LED69.2 (DIN)
D69: LED69.4 (DOUT), LED70.2 (DIN)
D70: LED70.4 (DOUT), LED71.2 (DIN)
D71: LED71.4 (DOUT), LED72.2 (DIN)
D72: LED72.4 (DOUT), LED73.2 (DIN)
D73: LED73.4 (DOUT), LED74.2 (DIN)
D74: LED74.4 (DOUT), LED75.2 (DIN)
D75: LED75.4 (DOUT), LED76.2 (DIN)
D76: LED76.4 (DOUT), LED77.2 (DIN)
D77: LED77.4 (DOUT), LED78.2 (DIN)
D78: LED78.4 (DOUT), LED79.2 (DIN)
D79: LED79.4 (DOUT), LED80.2 (DIN)
D80: LED80.4 (DOUT), LED81.2 (DIN)
D81: LED81.4 (DOUT), LED82.2 (DIN)
D82: LED82.4 (DOUT), LED83.2 (DIN)
D83: LED83.4 (DOUT), LED84.2 (DIN)
D84: LED84.4 (DOUT), LED85.2 (DIN)
D85: LED85.4 (DOUT), LED86.2 (DIN)
D86: LED86.4 (DOUT), LED87.2 (DIN)
D87: LED87.4 (DOUT), LED88.2 (DIN)
D88: LED88.4 (DOUT), LED89.2 (DIN)
D89: LED89.4 (DOUT), LED90.2 (DIN)
D90: LED90.4 (DOUT), LED91.2 (DIN)
D91: LED91.4 (DOUT), LED92.2 (DIN)
D92: LED92.4 (DOUT), LED93.2 (DIN)
D93: LED93.4 (DOUT), LED94.2 (DIN)
D94: LED94.4 (DOUT), LED95.2 (DIN)
D95: LED95.4 (DOUT), LED96.2 (DIN)
D96: LED96.4 (DOUT), LED97.2 (DIN)
D97: LED97.4 (DOUT), LED98.2 (DIN)
D98: LED98.4 (DOUT), LED99.2 (DIN)
D99: LED99.4 (DOUT), LED100.2 (DIN)
D100: LED100.4 (DOUT), LED101.2 (DIN)
D101: LED101.4 (DOUT), LED102.2 (DIN)
D102: LED102.4 (DOUT), LED103.2 (DIN)
D103: LED103.4 (DOUT), LED104.2 (DIN)
D104: LED104.4 (DOUT), LED105.2 (DIN)
D105: LED105.4 (DOUT), LED106.2 (DIN)
D106: LED106.4 (DOUT), LED107.2 (DIN)
D107: LED107.4 (DOUT), LED108.2 (DIN)
D108: LED108.4 (DOUT), LED109.2 (DIN)
D109: LED109.4 (DOUT), LED110.2 (DIN)
D110: LED110.4 (DOUT), LED111.2 (DIN)
D111: LED111.4 (DOUT), LED112.2 (DIN)
D112: LED112.4 (DOUT), LED113.2 (DIN)
D113: LED113.4 (DOUT), LED114.2 (DIN)
D114: LED114.4 (DOUT), LED115.2 (DIN)
D115: LED115.4 (DOUT), LED116.2 (DIN)
D116: LED116.4 (DOUT), LED117.2 (DIN)
D117: LED117.4 (DOUT), LED118.2 (DIN)
D118: LED118.4 (DOUT), LED119.2 (DIN)
D119: LED119.4 (DOUT), LED120.2 (DIN)
D120: LED120.4 (DOUT), LED121.2 (DIN)
D121: LED121.4 (DOUT), LED122.2 (DIN)
D122: LED122.4 (DOUT), LED123.2 (DIN)
D123: LED123.4 (DOUT), LED124.2 (DIN)
D124: LED124.4 (DOUT), LED125.2 (DIN)
D125: LED125.4 (DOUT), LED126.2 (DIN)
D126: LED126.4 (DOUT), LED127.2 (DIN)
D127: LED127.4 (DOUT), LED128.2 (DIN)
D128: LED128.4 (DOUT), LED129.2 (DIN)
D129: LED129.4 (DOUT), LED130.2 (DIN)
D130: LED130.4 (DOUT), LED131.2 (DIN)
D131: LED131.4 (DOUT), LED132.2 (DIN)
D132: LED132.4 (DOUT), LED133.2 (DIN)
D133: LED133.4 (DOUT), LED134.2 (DIN)
D134: LED134.4 (DOUT), LED135.2 (DIN)
D135: LED135.4 (DOUT), LED136.2 (DIN)
D136: LED136.4 (DOUT), LED137.2 (DIN)
D137: LED137.4 (DOUT), LED138.2 (DIN)
D138: LED138.4 (DOUT), LED139.2 (DIN)
D139: LED139.4 (DOUT), LED140.2 (DIN)
D140: LED140.4 (DOUT), LED141.2 (DIN)
D141: LED141.4 (DOUT), LED142.2 (DIN)
D142: LED142.4 (DOUT), LED143.2 (DIN)
D143: LED143.4 (DOUT), LED144.2 (DIN)
D144: LED144.4 (DOUT), LED145.2 (DIN)
D145: LED145.4 (DOUT), LED146.2 (DIN)
D146: LED146.4 (DOUT), LED147.2 (DIN)
D147: LED147.4 (DOUT), LED148.2 (DIN)
D148: LED148.4 (DOUT), LED149.2 (DIN)
D149: LED149.4 (DOUT), LED150.2 (DIN)
D150: LED150.4 (DOUT), LED151.2 (DIN)
D151: LED151.4 (DOUT), LED152.2 (DIN)
D152: LED152.4 (DOUT), LED153.2 (DIN)
D153: LED153.4 (DOUT), LED154.2 (DIN)
D154: LED154.4 (DOUT), LED155.2 (DIN)
D155: LED155.4 (DOUT), LED156.2 (DIN)
D156: LED156.4 (DOUT), LED157.2 (DIN)
D157: LED157.4 (DOUT), LED158.2 (DIN)
D158: LED158.4 (DOUT), LED159.2 (DIN)
D159: LED159.4 (DOUT), LED160.2 (DIN)
D160: LED160.4 (DOUT), LED161.2 (DIN)
D161: LED161.4 (DOUT), LED162.2 (DIN)
D162: LED162.4 (DOUT), LED163.2 (DIN)
D163: LED163.4 (DOUT), LED164.2 (DIN)
D164: LED164.4 (DOUT), LED165.2 (DIN)
D165: LED165.4 (DOUT), LED166.2 (DIN)
D166: LED166.4 (DOUT), LED167.2 (DIN)
D167: LED167.4 (DOUT), LED168.2 (DIN)
D168: LED168.4 (DOUT), LED169.2 (DIN)
D169: LED169.4 (DOUT), LED170.2 (DIN)
D170: LED170.4 (DOUT), LED171.2 (DIN)
D171: LED171.4 (DOUT), LED172.2 (DIN)
D172: LED172.4 (DOUT), LED173.2 (DIN)
D173: J_OUT.7 (P4a), J_OUT.8 (P4b), LED173.4 (DOUT)
GND: C1.2, C2.2, C3.2, C4.2, C5.2, C6.2, C7.2, C8.2, C9.2, C10.2, C11.2, C12.2, C13.2, C14.2, C15.2, C16.2, C17.2, C18.2, C19.2, C20.2, C21.2, C22.2, C23.2, C24.2, C25.2, C26.2, C27.2, C28.2, C29.2, C30.2, C31.2, C32.2, C33.2, C34.2, C35.2, C36.2, C37.2, C38.2, C39.2, C40.2, C41.2, C42.2, C43.2, C44.2, C45.2, C46.2, C47.2, C48.2, C49.2, C50.2, C51.2, C52.2, C53.2, C54.2, C55.2, C56.2, C57.2, C58.2, C59.2, C60.2, C61.2, C62.2, C63.2, C64.2, C65.2, C66.2, C67.2, C68.2, C69.2, C70.2, C71.2, C72.2, C73.2, C74.2, C75.2, C76.2, C77.2, C78.2, C79.2, C80.2, C81.2, C82.2, C83.2, C84.2, C85.2, C86.2, C87.2, C88.2, C89.2, C90.2, C91.2, C92.2, C93.2, C94.2, C95.2, C96.2, C97.2, C98.2, C99.2, C100.2, C101.2, C102.2, C103.2, C104.2, C105.2, C106.2, C107.2, C108.2, C109.2, C110.2, C111.2, C112.2, C113.2, C114.2, C115.2, C116.2, C117.2, C118.2, C119.2, C120.2, C121.2, C122.2, C123.2, C124.2, C125.2, C126.2, C127.2, C128.2, C129.2, C130.2, C131.2, C132.2, C133.2, C134.2, C135.2, C136.2, C137.2, C138.2, C139.2, C140.2, C141.2, C142.2, C143.2, C144.2, C145.2, C146.2, C147.2, C148.2, C149.2, C150.2, C151.2, C152.2, C153.2, C154.2, C155.2, C156.2, C157.2, C158.2, C159.2, C160.2, C161.2, C162.2, C163.2, C164.2, C165.2, C166.2, C167.2, C168.2, C169.2, C170.2, C171.2, C172.2, C173.2, J_IN.3 (P2a), J_IN.4 (P2b), J_IN.5 (P3a), J_IN.6 (P3b), J_OUT.3 (P2a), J_OUT.4 (P2b), J_OUT.5 (P3a), J_OUT.6 (P3b), LED1.1 (GND), LED2.1 (GND), LED3.1 (GND), LED4.1 (GND), LED5.1 (GND), LED6.1 (GND), LED7.1 (GND), LED8.1 (GND), LED9.1 (GND), LED10.1 (GND), LED11.1 (GND), LED12.1 (GND), LED13.1 (GND), LED14.1 (GND), LED15.1 (GND), LED16.1 (GND), LED17.1 (GND), LED18.1 (GND), LED19.1 (GND), LED20.1 (GND), LED21.1 (GND), LED22.1 (GND), LED23.1 (GND), LED24.1 (GND), LED25.1 (GND), LED26.1 (GND), LED27.1 (GND), LED28.1 (GND), LED29.1 (GND), LED30.1 (GND), LED31.1 (GND), LED32.1 (GND), LED33.1 (GND), LED34.1 (GND), LED35.1 (GND), LED36.1 (GND), LED37.1 (GND), LED38.1 (GND), LED39.1 (GND), LED40.1 (GND), LED41.1 (GND), LED42.1 (GND), LED43.1 (GND), LED44.1 (GND), LED45.1 (GND), LED46.1 (GND), LED47.1 (GND), LED48.1 (GND), LED49.1 (GND), LED50.1 (GND), LED51.1 (GND), LED52.1 (GND), LED53.1 (GND), LED54.1 (GND), LED55.1 (GND), LED56.1 (GND), LED57.1 (GND), LED58.1 (GND), LED59.1 (GND), LED60.1 (GND), LED61.1 (GND), LED62.1 (GND), LED63.1 (GND), LED64.1 (GND), LED65.1 (GND), LED66.1 (GND), LED67.1 (GND), LED68.1 (GND), LED69.1 (GND), LED70.1 (GND), LED71.1 (GND), LED72.1 (GND), LED73.1 (GND), LED74.1 (GND), LED75.1 (GND), LED76.1 (GND), LED77.1 (GND), LED78.1 (GND), LED79.1 (GND), LED80.1 (GND), LED81.1 (GND), LED82.1 (GND), LED83.1 (GND), LED84.1 (GND), LED85.1 (GND), LED86.1 (GND), LED87.1 (GND), LED88.1 (GND), LED89.1 (GND), LED90.1 (GND), LED91.1 (GND), LED92.1 (GND), LED93.1 (GND), LED94.1 (GND), LED95.1 (GND), LED96.1 (GND), LED97.1 (GND), LED98.1 (GND), LED99.1 (GND), LED100.1 (GND), LED101.1 (GND), LED102.1 (GND), LED103.1 (GND), LED104.1 (GND), LED105.1 (GND), LED106.1 (GND), LED107.1 (GND), LED108.1 (GND), LED109.1 (GND), LED110.1 (GND), LED111.1 (GND), LED112.1 (GND), LED113.1 (GND), LED114.1 (GND), LED115.1 (GND), LED116.1 (GND), LED117.1 (GND), LED118.1 (GND), LED119.1 (GND), LED120.1 (GND), LED121.1 (GND), LED122.1 (GND), LED123.1 (GND), LED124.1 (GND), LED125.1 (GND), LED126.1 (GND), LED127.1 (GND), LED128.1 (GND), LED129.1 (GND), LED130.1 (GND), LED131.1 (GND), LED132.1 (GND), LED133.1 (GND), LED134.1 (GND), LED135.1 (GND), LED136.1 (GND), LED137.1 (GND), LED138.1 (GND), LED139.1 (GND), LED140.1 (GND), LED141.1 (GND), LED142.1 (GND), LED143.1 (GND), LED144.1 (GND), LED145.1 (GND), LED146.1 (GND), LED147.1 (GND), LED148.1 (GND), LED149.1 (GND), LED150.1 (GND), LED151.1 (GND), LED152.1 (GND), LED153.1 (GND), LED154.1 (GND), LED155.1 (GND), LED156.1 (GND), LED157.1 (GND), LED158.1 (GND), LED159.1 (GND), LED160.1 (GND), LED161.1 (GND), LED162.1 (GND), LED163.1 (GND), LED164.1 (GND), LED165.1 (GND), LED166.1 (GND), LED167.1 (GND), LED168.1 (GND), LED169.1 (GND), LED170.1 (GND), LED171.1 (GND), LED172.1 (GND), LED173.1 (GND)
