matthewlaujh/the-sun/kicad/sun-A/sun-A.kicad_pcb

## KiCad design kicad/sun-A/sun-A.kicad_pcb (continued)

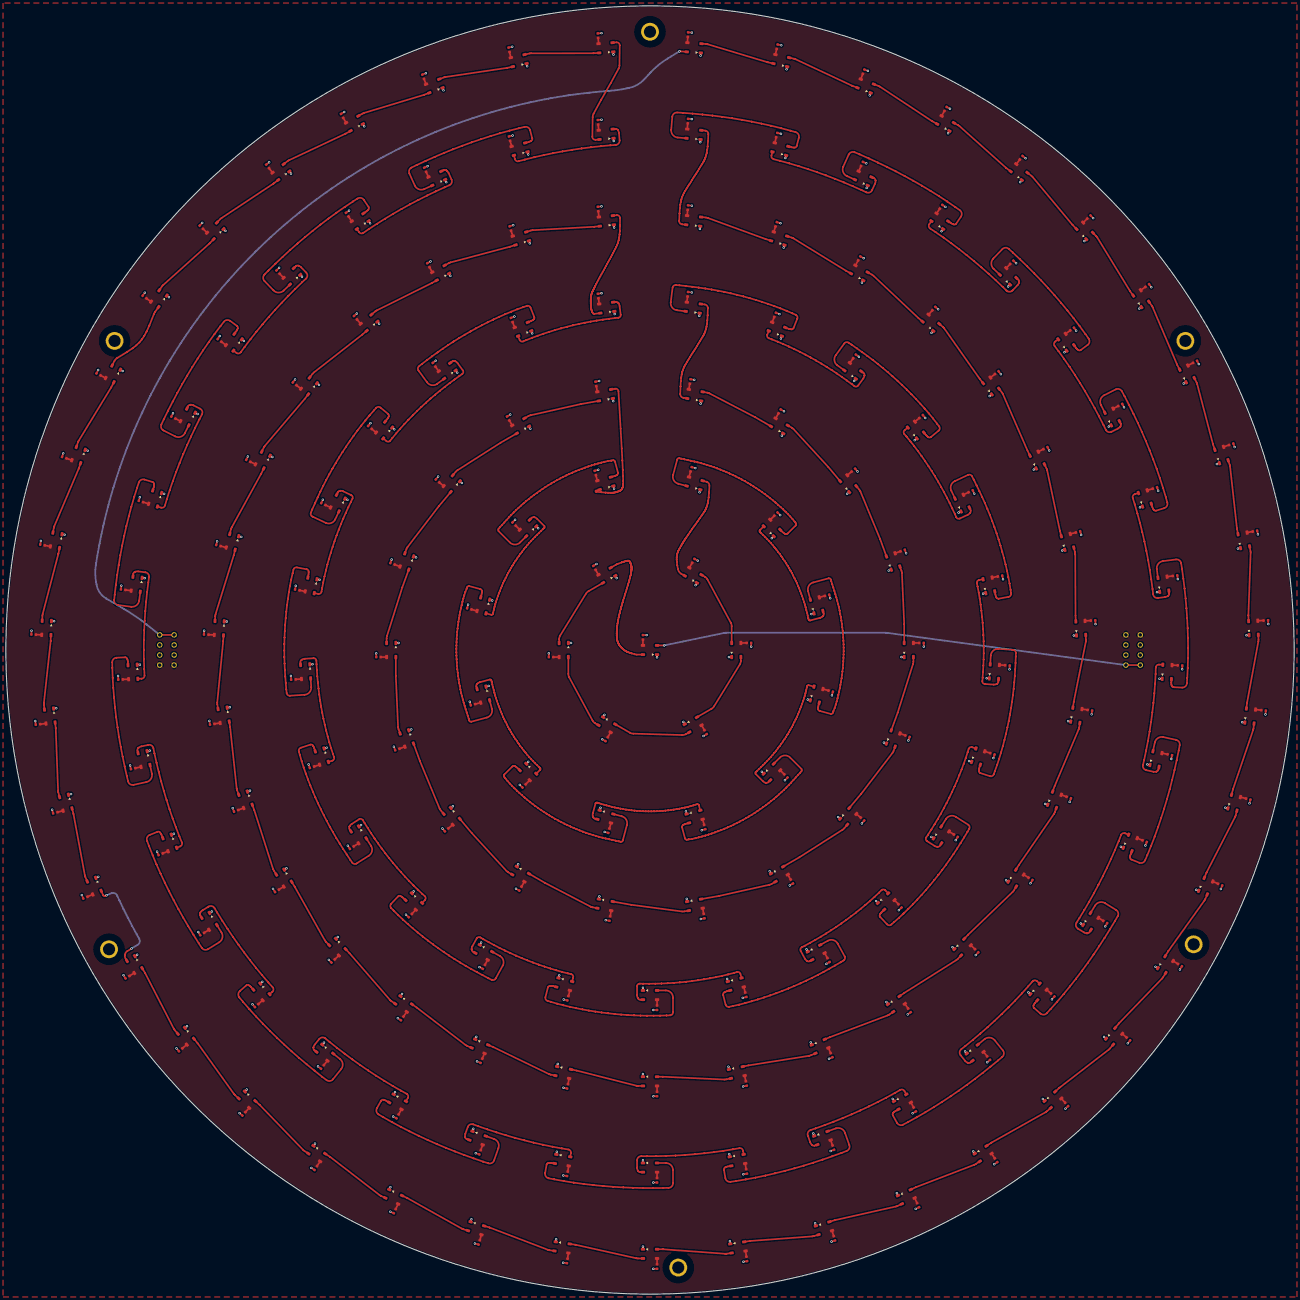
[picture p14: board sun-A.kicad_pcb from above]

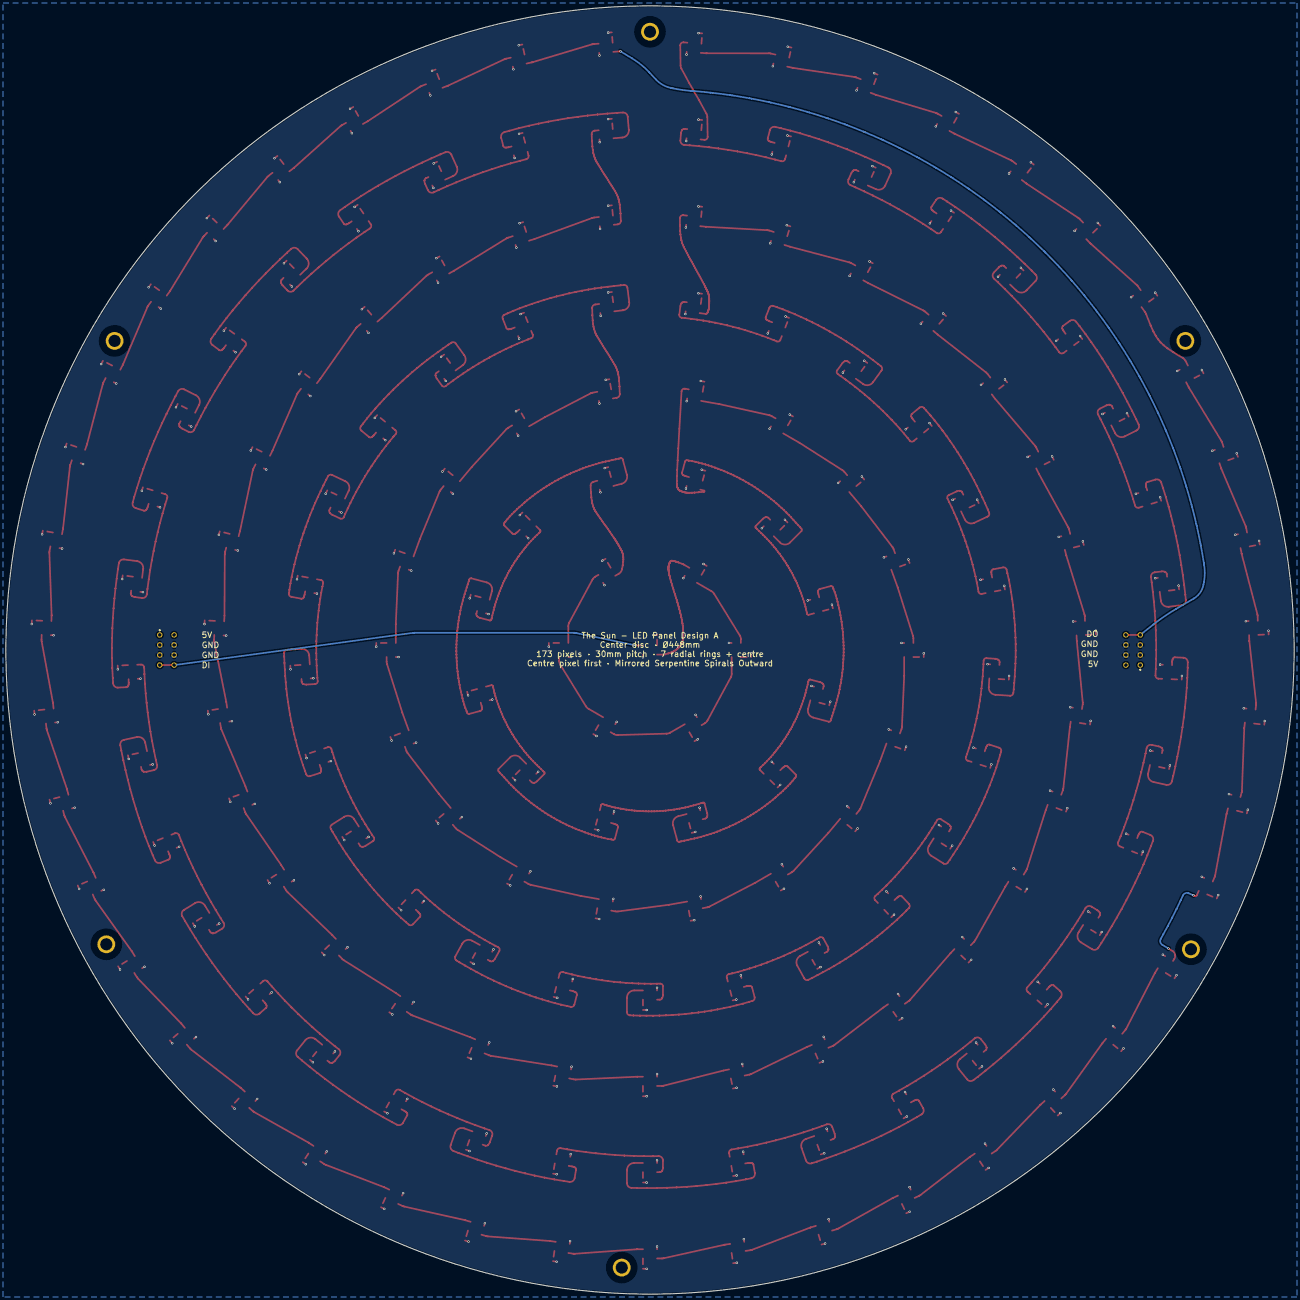
[picture p15: board sun-A.kicad_pcb from below]

Board: 2 copper layers, 448.0 x 448.0 mm, 354 parts (8 on the bottom side), 176 nets.
