matthewlaujh/the-sun/sample/sample.kicad_sch

## KiCad design sample/sample.kicad_sch (2026-10-01)

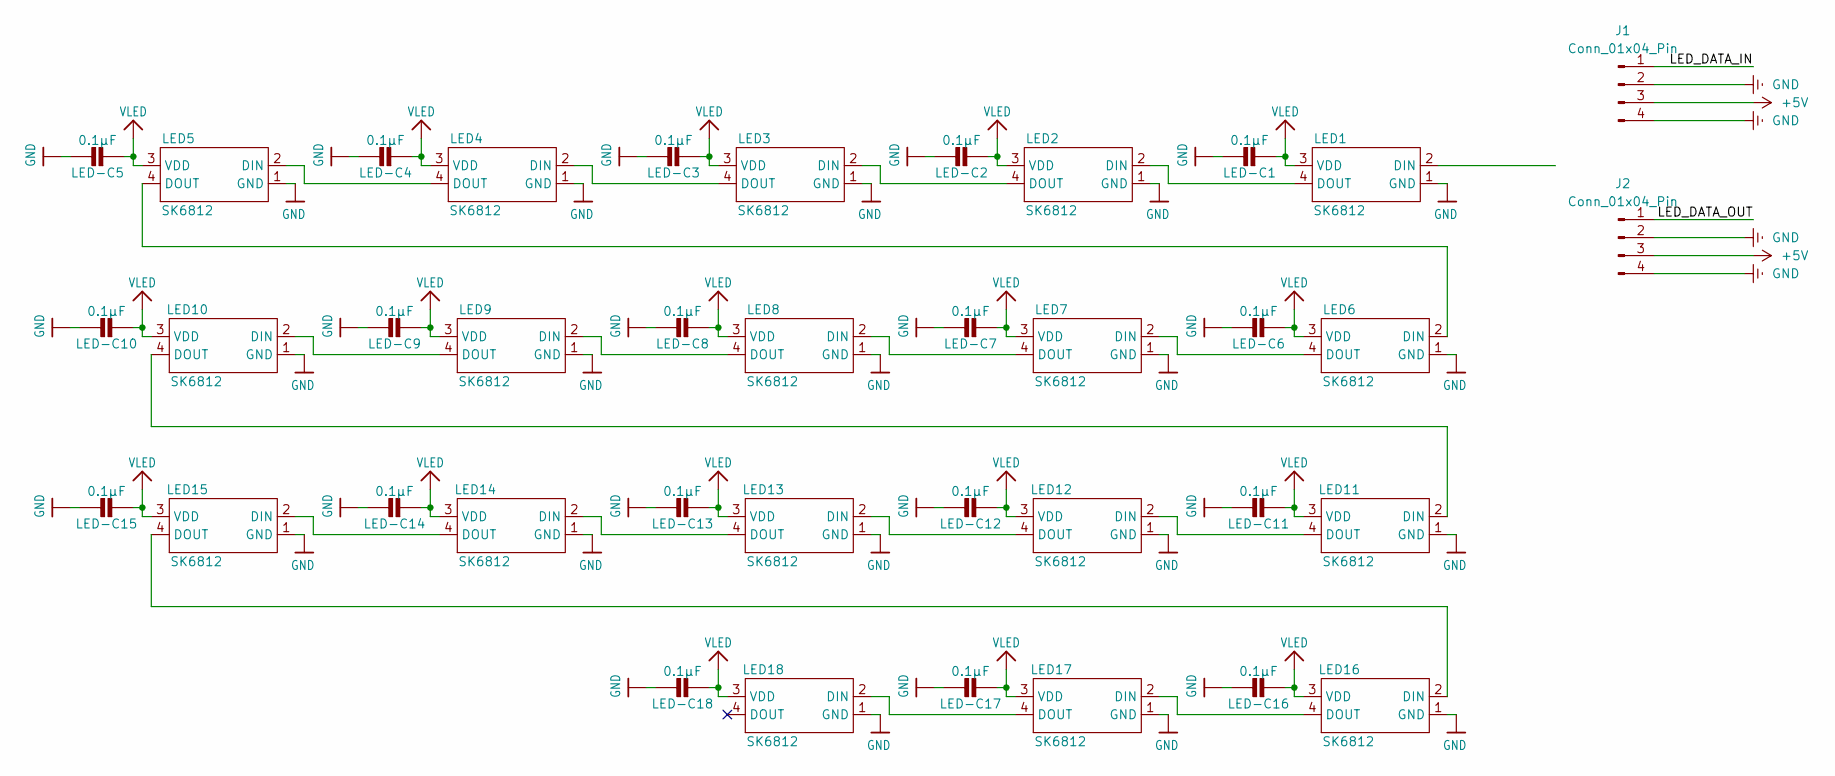
[picture p16: schematic sample.kicad_sch]

Parts:
J1, J2: Conn_01x04_Pin
LED1, LED2, LED3, LED4, LED5, LED6, LED7, LED8, LED9, LED10, LED11, LED12, LED13, LED14, LED15, LED16, LED17, LED18: SK6812; LED-SMD_4P-L5.0-W4.9-BR; Manufacturer Part SKC6812RGBW-NW-B; LCSC Part Name SKC6812RGBW-NW-B
LED-C1, LED-C2, LED-C3, LED-C4, LED-C5, LED-C6, LED-C7, LED-C8, LED-C9, LED-C10, LED-C11, LED-C12, LED-C13, LED-C14, LED-C15, LED-C16, LED-C17, LED-C18: 0.1µF; C_0201_0603Metric

Connections:
+5V: J1.3, J2.3
GND: J1.2, J1.4, J2.2, J2.4, LED1.1 (GND), LED2.1 (GND), LED3.1 (GND), LED4.1 (GND), LED5.1 (GND), LED6.1 (GND), LED7.1 (GND), LED8.1 (GND), LED9.1 (GND), LED10.1 (GND), LED11.1 (GND), LED12.1 (GND), LED13.1 (GND), LED14.1 (GND), LED15.1 (GND), LED16.1 (GND), LED17.1 (GND), LED18.1 (GND), LED-C1.1, LED-C2.1, LED-C3.1, LED-C4.1, LED-C5.1, LED-C6.1, LED-C7.1, LED-C8.1, LED-C9.1, LED-C10.1, LED-C11.1, LED-C12.1, LED-C13.1, LED-C14.1, LED-C15.1, LED-C16.1, LED-C17.1, LED-C18.1
LED_DATA_IN: J1.1
LED_DATA_OUT: J2.1
unnamed: LED1.4 (DOUT), LED2.2 (DIN)
unnamed: LED2.4 (DOUT), LED3.2 (DIN)
unnamed: LED3.4 (DOUT), LED4.2 (DIN)
unnamed: LED4.4 (DOUT), LED5.2 (DIN)
unnamed: LED5.4 (DOUT), LED6.2 (DIN)
unnamed: LED6.4 (DOUT), LED7.2 (DIN)
unnamed: LED7.4 (DOUT), LED8.2 (DIN)
unnamed: LED8.4 (DOUT), LED9.2 (DIN)
unnamed: LED9.4 (DOUT), LED10.2 (DIN)
unnamed: LED10.4 (DOUT), LED11.2 (DIN)
unnamed: LED11.4 (DOUT), LED12.2 (DIN)
unnamed: LED12.4 (DOUT), LED13.2 (DIN)
unnamed: LED13.4 (DOUT), LED14.2 (DIN)
unnamed: LED14.4 (DOUT), LED15.2 (DIN)
unnamed: LED15.4 (DOUT), LED16.2 (DIN)
unnamed: LED16.4 (DOUT), LED17.2 (DIN)
unnamed: LED17.4 (DOUT), LED18.2 (DIN)
VLED: LED1.3 (VDD), LED2.3 (VDD), LED3.3 (VDD), LED4.3 (VDD), LED5.3 (VDD), LED6.3 (VDD), LED7.3 (VDD), LED8.3 (VDD), LED9.3 (VDD), LED10.3 (VDD), LED11.3 (VDD), LED12.3 (VDD), LED13.3 (VDD), LED14.3 (VDD), LED15.3 (VDD), LED16.3 (VDD), LED17.3 (VDD), LED18.3 (VDD), LED-C1.2, LED-C2.2, LED-C3.2, LED-C4.2, LED-C5.2, LED-C6.2, LED-C7.2, LED-C8.2, LED-C9.2, LED-C10.2, LED-C11.2, LED-C12.2, LED-C13.2, LED-C14.2, LED-C15.2, LED-C16.2, LED-C17.2, LED-C18.2
