matthewlaujh/the-sun/firmware/sun_show/src/relief_nb.h

// GENERATED from sun_map.h — 6 nearest neighbours per pixel and least-squares gradient weights (x128, per 30 mm pitch)
// for the relief (W-die 3D shading). Lives in flash: no heap, no boot-time search. Regenerate if the pixel map changes.
#pragma once
#include <stdint.h>
#define RELIEF_NB 6
static const uint16_t RELIEF_NBR[14502] = {2,5,1,3,4,6,6,0,2,17,18,7,0,1,3,15,16,14,4,0,2,14,13,12,3,0,5,11,12,13,0,4,6,9,10,8,1,0,5,8,7,18,36,18,8,6,35,19,34,7,9,6,35,33,33,10,8,5,32,34,31,9,11,5,32,30,30,10,12,4,29,31,28,13,11,4,29,27,27,12,14,3,26,28,25,13,15,3,26,24,24,16,14,2,23,25,22,15,17,2,23,21,21,16,18,1,20,22,19,7,17,1,20,36,61,18,36,20,60,37,21,19,59,60,18,17,58,17,20,22,59,57,16,21,23,57,56,17,55,22,24,15,16,56,54,15,25,23,53,55,14,26,24,52,53,15,51,25,27,13,14,52,13,50,28,26,49,12,12,48,27,29,49,13,47,30,28,12,11,46,11,29,31,46,45,10,44,10,30,32,45,43,43,31,33,9,10,42,9,34,32,41,42,8,40,8,35,33,39,41,34,36,39,38,7,8,37,7,19,35,38,61,61,38,92,36,91,62,39,37,91,35,90,36,38,40,89,35,90,34,41,34,39,88,89,87,40,42,87,33,86,34,43,41,86,33,85,32,42,44,32,84,85,31,45,43,31,83,84,82,82,46,44,30,31,81,45,47,81,30,80,29,48,46,29,79,80,28,49,47,78,28,79,29,77,48,50,27,28,76,49,51,76,27,75,26,50,52,26,75,74,27,53,51,73,25,74,26,72,52,54,25,24,73,53,55,24,71,70,72,56,54,23,70,69,24,55,57,68,22,69,23,58,56,67,22,68,21,57,21,59,66,65,67,60,58,65,20,64,21,59,61,63,20,64,19,37,60,62,19,63,92,129,61,63,92,128,37,62,64,128,60,127,61,63,65,127,126,59,60,66,64,125,59,126,58,124,58,67,65,125,57,123,57,66,68,122,124,69,67,122,56,121,57,70,68,121,55,120,56,69,71,119,55,120,54,118,72,70,54,119,53,53,117,71,73,116,118,74,72,116,52,115,53,75,73,115,51,114,52,74,76,113,51,114,50,77,75,112,50,113,49,49,111,76,78,110,112,77,79,110,48,109,49,80,78,109,47,108,48,79,81,107,47,108,46,80,82,106,46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
28,30,-29,-28,28,-1,2,30,-29,28,-28,16,-15,44,-12,16,-15,16,31,1,31,17,15,-15,32,2,32,17,-14,15,3,32,32,18,-14,15,4,32,32,18,14,-13,5,32,32,19,14,-13,32,6,32,19,-12,13,7,31,32,17,4,-3,21,14,36,17,3,-2,15,20,36,18,3,-2,20,16,36,18,-1,2,16,20,36,18,-1,2,19,17,36,18,1,0,18,19,36,18,0,1,18,19,36};
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
