matthewlaujh/the-sun/(commit log)

2026-08-16 kicad pack test
    [boards.csv, design-A-outline.dxf, design-A-placement.csv, design-B-outline.dxf, design-B-placement.csv, design-C-outline.dxf, design-C-placement.csv, dmx-patch.csv]
2026-08-26 KiCad draft 3.11: uniform radial LED orientation, standoff keep-away routing, 1oz fab notes
    - sun-A/B/C boards + shared sun-lib, generated from the 2026-08-17 DXF v2 pack
    - all LEDs uniform radial (GND corner bottom-right), caps identical beside 5V pin
    - front wrap routing (in/out alternating), copper >=2.4mm from standoff holes
    - routing clearance 0.45 (DRC class 0.35), courtyard margin 0.5
    - WAGOs: A pair exact E-W at r=195, B/C docked on radial edges, back side
    Claude-Session: https://claude.ai/code/session_01X7gzx2BKdLPFQ8yv2yozUg
    [bom.csv, designators.csv, positions.csv, sun-A.kicad_pcb, sun-A.kicad_sch, sun-B.kicad_pcb, sun-B.kicad_sch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]
2026-08-30 KiCad drafts 3.12+3.13: isolated mounting holes, A centre pixel wired per design pack 3
    - all mounting holes electrically isolated (pad no-net + copper-free moat
    both layers, Ø9mm); schematic MH pins no-connect; standoffs float
    - board A: centre standoff removed, LED173 added at the exact centre
    - board A chain re-ordered to match sunleddesignpack 3: centre = first
    pixel (universe 1 ch 1), serpentine mirrored; planner dmx-patch/led-map
    apply with no hand edits; A bom/cpl renumbered accordingly
    - feed = straight B.Cu run J_IN->centre; return = ring-210 band arc to J_OUT
    - verify + audit + strict layered connectivity: 0 problems on A/B/C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
    [bom.csv, sun-A.kicad_pcb, sun-A.kicad_sch, sun-B.kicad_pcb, sun-B.kicad_sch, sun-C.kicad_pcb, sun-C.kicad_sch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]
2026-08-30 KiCad drafts 3.14-3.16: silk-free LED face, wider hole moats, centring, curved routing polish
    - front silk removed except a pin-1/GND triangle hidden UNDER each LED body
    (visible bare, covered once soldered); JLC order-number placeholder and
    board id moved to back silk; standoff refs to fab layer
    - mounting-hole copper moats widened to O11mm; all copper >=3.0mm from hole
    edges (verified >=2.8)
    - board A: WAGO pair body-centred between rings 180/210 (pin centre r199.06,
    still exactly opposite on E-W); all six standoffs at uniform r=215
    (frame spoke holes move 3.5mm inward accordingly)
    - no trace under any LED/cap body on EITHER copper layer; A's back-layer
    feed re-routed between f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
    [sun-A.kicad_pcb, sun-B.kicad_pcb, sun-C.kicad_pcb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]
2026-08-30 KiCad 9 save: boards migrated to v9 format, zones filled
    sun-A/B/C .kicad_pcb opened and saved in KiCad 9.0 (format 20241229),
    copper pours filled; project local settings (.kicad_prl) updated.
    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
    [sun-A.kicad_pcb, sun-B.kicad_pcb, sun-C.kicad_pcb]
2026-08-30 KiCad 9 re-saves + fabrication exports for all three boards
    - sun-A: zones filled and saved, project settings updated, stale
    ~sun-A.kicad_pcb.lck removed; NEW production/ exports + fabrication
    toolkit options
    - sun-B: re-save churn (fp-info-cache, prl/pro); NEW production/
    exports + fabrication toolkit options
    - sun-C: refreshed production exports (netlist.ipc, positions.csv,
    sun-C.zip) and re-save updates
    [bom.csv, designators.csv, positions.csv, sun-A.kicad_pcb, sun-B.kicad_pcb, sun-C.kicad_pcb]
2026-08-30 Fill LCSC part numbers into production BOMs + ordering checklist
    - bom.csv (A/B/C): cap C1591, LED C5348912 (SKC6812RGBW-NW),
    standoff C20617225; WAGO left unmatched (hand-solder, DNP at JLC)
    - ORDERING.md: quantities, fab/assembly settings, buy-elsewhere list;
    standoff finding: C20617225 is the 3mm SMT nut matching our footprint,
    30mm riser is separate M3 hardware
    [bom.csv]
2026-08-30 Remove WAGO rows from production BOMs (hand-soldered, not for JLC assembly)
    [bom.csv]
2026-08-30 Gerber review fixes: sun-C WAGO labels to back silk, restore JLC order-number placeholder
    - sun-C: the 8 hand-added pole labels (5V/GND/GND/DI, 5V/GND/GND/DO)
    were on F.SilkS with mirror justify - would have printed mirrored on
    the sun's visible face; moved to B.SilkS (matches A/B)
    - all boards: JLCJLCJLCJLC placeholder re-added on B.SilkS below the
    spec text (was lost with the old back title) so JLC's order number
    lands on the back, not wherever they choose
    - ORDERING.md: re-export production folders before uploading
    [sun-A.kicad_pcb, sun-B.kicad_pcb, sun-C.kicad_pcb]
2026-08-30 Drop JLC order-number placeholder - no serials on the boards
    Removed the JLCJLCJLCJLC gr_text from all three backs; ORDERING.md now
    says to tick 'Remove Order Number' at JLC checkout instead.
    [sun-A.kicad_pcb, sun-B.kicad_pcb, sun-C.kicad_pcb]
2026-08-30 Re-exported production files (post silk fixes) + BOMs refilled
    - KiCad re-exports of all three production folders picking up the C
    label fix and placeholder removal (verified in gerbers)
    - bom.csv x3: LCSC numbers re-applied (C1591 / C5348912 / C20617225),
    WAGO rows dropped again (hand-solder)
    - old backup zips removed by user
    [sun-B.kicad_pcb, sun-C.kicad_pcb]
2026-09-02 Draft 3.17: relocate all WAGOs clear of the mounting system (>=10mm)
    Mount geometry from leds-with-mounts.dxf loaded into the generator as a
    placement keep-away (registration vs the 150 mount holes: 0.005mm).
    - A: pair moved a ring inward to r=168.0, still exactly E-W; hub plate
    (r199.5-247.6) now cleared by 18.4mm; feed/return re-routed
    - B: J_IN redocked (depth 24.0, slide 30 -> 21.7mm clear), J_OUT
    (depth 26.5 -> 13.1mm clear)
    - C: J_IN slid 30mm along its edge (19.2mm clear), J_OUT redocked
    (depth 26.5 -> 13.1mm clear)
    - verify 0 @0.35 / audit 0 / under-body 0 / 0 route fails on all boards
    - schematics + README regenerated
    NOTE: regenerated v8 boards replace the KiCad-9 saves - re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
    [sun-A.kicad_pcb, sun-B.kicad_pcb, sun-C.kicad_pcb]
2026-09-03 Draft 3.18: WAGO grid for cable management (beam lanes, in/out on opposite edges)
    User plan: trunk wires run down the skeleton seam beams and break out to
    the connectors. Every wedge connector now docks at a UNIFORM 35mm offset
    from its edge line, wire entry facing the beam, on fixed rings:
    - B: J_IN r270.0 on the low edge, J_OUT r645.0 on the high edge
    - C: J_IN r701.0 low, J_OUT r830.0 high
    - A: pair unchanged (r168.0, exactly 0/180 - beam angles)
    In the assembly each seam beam carries an aligned in+out from its two
    adjacent wedges, so chain hops and the pair power link run along beams.
    Mount clearances 15.9-20.2mm (>=10 required); verify 0 @0.35 / audit 0 /
    under-body 0 (checked against f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
    [sun-B.kicad_pcb, sun-C.kicad_pcb]
2026-09-03 Draft 3.18c: wedge WAGOs one LED column deeper (65mm off beams)
    User: wedge connectors still too near the mounts. BEAM_OFF 35 -> 65mm
    (between LED columns 1 and 2); rings now B 285/645, C 700/827 (B J_IN
    270->285 to clear column 2; C J_OUT 830->827 for the 14mm court-to-edge
    audit law). A disc unchanged. Mount clearances now A 18.4, B 35.2/22.4,
    C 20.6/17.4mm. verify 0 / audit 0 / under-body 0 / 0 route fails.
    Also adds layout-dxf/sun-assembly-with-mounts.dxf (his mount system +
    current layout, sun-centred frame) + earlier per-board layout DXFs.
    Reopen in KiCad 9: fill zones, save, DRC/ERC, re-export production.
    Claude-Session: https:/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
    [sun-A-layout.dxf, sun-B-layout.dxf, sun-B.kicad_pcb, sun-C-layout.dxf, sun-C.kicad_pcb, sun-assembly-with-mounts.dxf, sun-assembly.dxf]
2026-09-03 Draft 3.18d: wedge WAGOs angled to the local radial (follow LED columns)
    Pole rows were parallel to the docking edge; at 65mm depth that reads
    ~14 deg skewed against the radial LED grid. Each connector's long axis
    now points at the sun centre from its own position (axis == local
    radial to 0.1 deg on all four classes); wire entry still faces the
    beam. Same rings (B 285/645, C 700/827) and 65mm offsets. Mount
    clearances B 37.2/21.9, C 21.2/16.6mm; verify 0 / audit 0 /
    under-body 0 / 0 route fails. A unchanged. Assembly-with-mounts DXF
    updated.
    Claude-Session: https://cla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
    [sun-B.kicad_pcb, sun-C.kicad_pcb, sun-assembly-with-mounts.dxf]
2026-09-03 Draft 3.18e: WAGOs centred on LED row midpoints; LED radial audit clean
    - LED rows are exact 30mm-pitch arcs (A 30..210, B 240..660, C 690..840).
    With radial pole rows the body is radially symmetric, so pin radius =
    row midpoint centres it: C J_IN 705 (was 700), C J_OUT 825 (was 827);
    B 285/645 were already midpoints. C routing back to 0 jogs.
    - Full LED audit from the written boards: all 2,417 LEDs exactly global
    radial (dot(+y_local, outward) = 1.00000000, zero deviations).
    - Mount clearances B 37.2/21.9, C 25.7/18.6mm; verify 0 / audit 0 /
    under-body 0 / 0 route fails. Assembly-with-mounts DXF updated.
    Co-Auth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
    [sun-C.kicad_pcb, sun-assembly-with-mounts.dxf]
2026-09-03 Draft 3.18f: restore Matthew's back silkscreen, baked into the generator
    The 3.17/3.18 regenerations had dropped his hand-added B.SilkS texts
    and resurrected the retired JLCJLCJLCJLC + 'draft3' marks. Now:
    - his three spec blocks emitted verbatim at his exact positions
    (pulled from git history, A converted between frames)
    - his 2mm bold 5V/GND/GND/DI-DO pole labels regenerated per connector
    (anchor/angle calibrated to his originals) so they FOLLOW the WAGOs
    - JLCJLCJLCJLC and 'sun-X draft3' emissions deleted from pcb.py
    verify 0 x3; silk inventory per board = exactly his 9 texts + GND
    triangles; placements/routing unchanged from 3.18e.
    Reopen in KiCad 9: fill zones, save, DRC/ERC, re-ex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
    [bom.csv, designators.csv, positions.csv, sun-A.kicad_pcb, sun-B.kicad_pcb, sun-C.kicad_pcb, sun-assembly-with-mounts.dxf]
2026-09-03 Draft 3.18g: regression audit vs pre-3.17 baseline; WAGO silk stripped to Matthew's edits
    Full inventory diff of every footprint/element class against the boards
    he uploaded to JLC (commit 7103939):
    - LEDs, caps, mounting holes: 0 position/rotation deltas on all boards
    (A modulo its known frame translation); zones, moats, edge cuts, net
    tables, silk text counts all identical
    - fp_rect->fp_poly count differences are KiCad 9 re-save format churn
    (geometry identical)
    - ONE real regression found: he had stripped the WAGO footprint silk
    (body rect, lever line, LEVER text, tiny pole letters) and hidden the
    reference; regens had restored them. wago_inst now emits only the
    pin-1 dot on s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
    [sun-A.kicad_pcb, sun-B.kicad_pcb, sun-C.kicad_pcb]
2026-09-03 Draft 3.19: A data-return routed mid-board, edge-hugging forbidden on the disc
    User: the return trace ran along the board edge. The old ladder's inward
    channel attempts failed on a GND via near 173 deg (blend descent too
    shallow) so an outward rim sweep won. Now: blend-angle variations
    (8/3/2/12 deg) per dive candidate so the descent to the connector
    threads the ring-180 LED gap steeply, wider mid-channel radius scan,
    and a hard cap on the disc (no return point beyond r=206; rim r=224).
    A's return now sweeps r166-208 between the outer LED rings.
    B/C returns re-derived identically. verify 0 / audit 0 / 0 route fails.
    Claude-Session: http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
    [sun-A.kicad_pcb]
2026-09-03 Draft 3.20: WAGO labels aligned+legible, wedge WAGOs at visual row-gap centres, D78 return clearance >=0.8, A return spaced mid-lane, spec text centred per board
    - Pole labels (5V/GND/GND/DI|DO) now anchored past the WAGO lever face
    (offset 8.65 -> 11.9), one per pole at 3.5mm pitch, angle unchanged
    - B WAGOs at r=286.35/646.35, C at r=706.35/826.35: visual gap centres
    between LED rows (caps intrude 5.2 inward, LED bodies 2.5 outward)
    - route.py: direct F.Cu return branches now require 0.8mm clearance
    (C D78 old pass was 0.718mm from LED78's GND via; now 4.29mm via channel)
    - A (disc) return channel pinned to r~196.5, mid-lane between the band-180
    F.Cu arcs (r~187) and the ring-210 l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
    [sun-A.kicad_pcb, sun-B.kicad_pcb, sun-C.kicad_pcb, sun-assembly-with-mounts.dxf]
2026-09-03 Draft 3.21: visual middles ignore caps, B J_IN at cursor spot, upright slant-matched labels, A return r195 into pad 7
    - Dock radius bug fixed: relocate_wago measured its radius on the edge line
    BEFORE the 65mm beam offset, so wedge pads sat sqrt(r^2+65^2) out --
    2.5-7.3mm outside every 3.18-3.20 target. GRID_R is now true pad-centre
    radius; measured B 274.27/645.10, C 705.09/825.08
    - Visual middle redefined per user: plain LED-row midpoints, caps ignored
    - B J_IN moved to the user's cursor mark (~11mm inward, pad r=274): housing
    xy overlaps LED row 270 (back vs front, fine); DI feed now runs straight
    - Pole labels: upright rule from his baseline hand labels (7103939) -- text
    reads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
    [sun-A.kicad_pcb, sun-B.kicad_pcb, sun-C.kicad_pcb, sun-assembly-with-mounts.dxf]
2026-09-03 Draft 3.22: data feeds land on the facing WAGO hole, D78 exits the pad bottom
    - Feed targets whichever DATA pin faces the incoming route (nearest to
    LED1's stub): C J_IN now pin 7 (user), B J_IN pin 7 (same geometry),
    A J_IN keeps pin 8; the 7-8 bridge joins the other pin
    - Return pad escape: direct F.Cu returns pick between the standard -x stub
    and a bottom-edge (-y) exit by least bend toward the connector -- C's D78
    no longer hairpins out the far side of the pad; one straight run to J_OUT
    - verify 0 @0.35 / audit 0 / all clearance laws pass
    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
    [sun-B.kicad_pcb, sun-C.kicad_pcb, sun-assembly-with-mounts.dxf]
2026-09-03 Draft 3.23: B's D109 return stops at pin 7
    Wedge returns now land on whichever DATA hole faces the last LED's stub
    (same facing-hole rule as the feeds): B J_OUT -> pin 7 (user; the old nav
    path ran under pin 7 to reach pad 8), C J_OUT keeps pad 8, A keeps pad 7.
    verify 0 / audit 0. A and C unchanged.
    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
    [sun-B.kicad_pcb, sun-assembly-with-mounts.dxf]
2026-09-03 Draft 3.24: B J_IN centred between LED6/LED7, WAGO housings are no-fly for foreign traces
    - B J_IN pad centre placed at sun angle 75.0 deg exactly (midpoint of
    LED6 @71.25 / LED7 @78.75), r=275.0 — angular dock target replaces the
    beam-edge walk for this connector; mount clearance 19.7mm
    - WAGO courtyards now block the FRONT copper too (were back-only): only
    nets that connect to a WAGO may cross under its housing; B's D6
    serpentine link reroutes around the housing's inner edge
    - Standing audit: zero foreign track elements under all six housings
    across A/B/C; verify 0 / audit 0; sun-A byte-identical (untouched)
    Claude-Session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
    [sun-B.kicad_pcb, sun-C.kicad_pcb, sun-assembly-with-mounts.dxf]
2026-09-03 Production 3.24: fresh Fabrication Toolkit exports, JLC-ready BOM/CPL, layout DXFs
    - Gerbers re-exported by Matthew from the 3.24 boards (zones filled);
    structural checks ALL PASS (layer sets, paste counts, drills: vias +
    16x1.2 WAGO pins + 4.22 standoffs, empty NPTH, extents inside edge);
    drill clusters match the 3.24 WAGO positions to the micron
    - bom.csv x3: LCSC filled (0603 -> C1591, SKC6812RGBW -> C5348912,
    standoff -> C20617225); WAGO row removed (hand-soldered)
    - positions.csv x3: J_IN/J_OUT rows removed (hand-soldered); BOM marker,
    CRLF and column format preserved for JLC's reader
    - kicad/layout-dxf: per-board layout DXFs regenerated from the fresh CPL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
    [bom.csv, designators.csv, positions.csv, sun-A-layout.dxf, sun-B-layout.dxf, sun-C-layout.dxf]
2026-09-03 Final master DXF: his leds-with-mounts drawing + 3.24 placements overlay
    sun-final-with-mounts.dxf = his original artwork verbatim (his frame,
    Layer 1) plus overlay layers: SUN-OUTLINE (25 board edges), SUN-WAGO
    (50 housings, pins, lever faces), SUN-LABEL (J_IN/J_OUT names),
    SUN-STANDOFF (106 standoff positions). Drawn from the written 3.24
    boards; assembly geometry as ordered at JLC.
    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
    [sun-final-with-mounts.dxf]
2026-09-16 Simulator v5: 3D light sim with BIG LIGHT 9.1 geometry, physical dome/opal optics, 52 patterns
    Claude-Session: https://claude.ai/code/session_01BK3tbxKdVZRtnoSHDdkc2A
    [sun-map.csv]
2026-10-01 Sun map: Rev Q C-flip + clockwise sector numbering; regenerate simulator data
    - Runs 6-8 chained in descending wedge order (C5->C4->C3->C2, C9->C8->C7->C6,
    C12->C11->C10) to shorten the C->C data hops. Pixel counts and start
    universes per output unchanged, so the PixLite patch stays as is.
    Originals kept as sun-map.pre-Cflip.*
    - Sectors now numbered clockwise from the top with East on the right, as
    seen from the LED side (matches boards.csv, the KiCad DXF and the wiring
    plan). The original map numbered them anticlockwise. Each Bk/Ck pixel
    block was rotated by 60(k-1) deg into its plan sector; intra-board
    geometry, radii, pitch, pixel order, runs and universes are unchanged.
    O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
2026-10-01 Firmware: ESP32-GATEWAY projects — disc bring-up test and full-rig test with OTA + scenes
    gateway_disc_test (first commit of the existing project): centre-disc
    bring-up (paint / chase / fluid shaders) via Wi-Fi AP SUN-DISC -> ESP32-GATEWAY
    -> Ethernet -> PixLite E4-S Mk3. README run table updated to Rev Q.
    gateway_rig_test (new): Advatek-Assistant-style channel/pixel test for the
    whole sun (2,417 px, 25 boards, 8 runs, 23 universes), map-aware via sun_map.h.
    - Select All / runs 1-8 / boards; modes: solid, chase (wire order), wipe,
    colour cycle, board step, universe step, ends, rainbow, breathe, radial,
    spot, scene. Colours A/B, master (30 % boot, x0.90 cap always), speed,
    tail, manu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
2026-10-01 gateway_rig_test: fix output task starving loop() — page/OTA went dead on heavy frames
    The output task (core 1, prio 3) paced itself with vTaskDelayUntil(25 ms).
    Once a frame took longer than that (scene render + shading + 23 Art-Net
    packets) it never slept, so Arduino loop() (core 1, prio 1) starved: no
    status pushes, no page mirror, no WebSocket cleanup, no OTA. LEDs kept
    running but the page looked dead.
    - Pace by measured frame time and always sleep >= 5 ms per frame.
    - Animation clocks (chase/wipe/rainbow/steps/scenes) advance by real dt,
    so speeds stay correct when fps drops.
    - Dome-shading NVS save debounced to 1.5 s after the last slider change
    (was every tick while dragging).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
2026-10-01 gateway_rig_test: per-ring dome shading, touch-safe sliders, faster render path
    - Dome shading is now a gain per pixel ring (the map has 29 rings at 30 mm
    pitch): the outer 12 rings (510-840 mm) get individual sliders, 0-480 mm
    share one. Range 0-2.00. Stored as 29 bytes in NVS ("shr").
    - Page: sliders and colour no longer snap back while dragging on touch
    devices. iOS does not focus range inputs, so the activeElement guard never
    fired and the 500 ms status echo overwrote in-progress changes. Replaced
    with a 1.5 s "recently touched" guard on every control.
    - Render path compiled -O2 -ffast-math (Arduino default is -Os; the Xtensa
    FPU has no divide, fast-math lets GCC use reciproc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
2026-10-01 gateway_rig_test: light the ring being tuned; config export/import
    - Dome shading: while a ring slider is touched the page sends the ring index
    and the ESP lights that ring magenta (inner group as a whole for the inner
    slider); auto-clears 2.5 s after the last movement. "light ring being
    tuned" checkbox turns it off so the real brightness can be judged.
    - GET /config.json exports network settings, the 29 ring gains + on/off and
    the current test state (mode, selection, colours, master, speed, scene
    settings) as one JSON file; POST /config imports it (network saved to NVS,
    shading saved, state applied live). Export / Import buttons in the
    Network panel.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
2026-10-01 gateway_rig_test: render scenes on both cores; drop per-pixel powf
    Solar surface was ~55 ms/frame (18 fps).
    - Scene frames are split between a helper task on core 0 and the output
    task on core 1; the split point adapts each frame so Wi-Fi bursts on
    core 0 don't stall it. Patterns now take a pixel range.
    - Palette contrast curve is a 256-entry table (was powf per pixel);
    integer powers in the patterns are multiplies. Output unchanged —
    verified against the simulator JS.
    Claude-Session: https://claude.ai/code/session_016L7YDN9gCLnsq3XMb5s8dN
2026-10-01 gateway_rig_test: race-free two-core render, housekeeping on core 0
    Scene mode died after ~5 s with the first two-core build.
    - Helper hand-off made race-free: the helper renders into its own buffer,
    a busy flag allows one job in flight, stale notifications are dropped,
    and a late helper means that frame is skipped for its share and the next
    frame runs single-core. The old code could slip a frame out of step and
    write unscaled pixels after the master/cap pass.
    - Helper yields one tick mid-job so core 0's idle task (watched by the task
    WDT, 5 s) and Wi-Fi always get a slot.
    - Housekeeping (status, page mirror, OTA, deferred NVS saves, WS cleanup)
    moved from loop() to a task pinned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
2026-10-01 gateway_rig_test: keep Wi-Fi/web responsive while both cores render
    Page was slow to load / connect after the two-core change.
    - The 70 kB pixel tables lived in flash, which both cores streamed through
    every frame via the single shared flash cache that also feeds the Wi-Fi
    stack's code. Hot tables (x, y, r, theta, run, board, RI, zone) are now
    copied to RAM at boot (~34 kB).
    - Housekeeping task raised above the render helper (3 vs 1) on core 0.
    - For 4 s after any HTTP request or WebSocket connect the scene renders
    single-core on core 1, leaving core 0 to serve the page.
    Claude-Session: https://claude.ai/code/session_016L7YDN9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
2026-10-01 gateway_rig_test: cut heap use by ~35 kB and gzip the page (blank-page fix)
    The page came up blank again: the HTML response was being cut off early
    (inside <style>) because the ESP ran short of TCP buffer memory after the
    RAM table copies.
    - Intent buffer is 16-bit fixed point (19 kB, was 39 kB floats).
    - Dropped the unused RI table copy and the separate mirror buffer.
    - Page is gzipped at build time (tools/gen_html_gz.py via extra_scripts,
    26 kB → 9.6 kB) and served from flash with Content-Encoding: gzip —
    faster over the AP and far less buffer pressure. index_html_gz.h is
    generated and gitignored.
    Claude-Session: https://c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
2026-10-01 gateway_rig_test: strip back to scenes + dome tuner; prioritise network and animation
    Three modes (off / solid / scene), the simulator scenes + palettes, the
    per-ring dome shading tuner with ring highlight, OTA, config export/import,
    minimal network panel. Removed from firmware and page: pixel map / map.bin,
    live frame mirror over WebSocket, run/board selection, chase / wipe / cycle /
    board step / universe step / ends / rainbow / breathe / radial / spot modes,
    Art-Net node discovery, colour B, DDP. (All still in history <= b82bf2d and
    the disc paint tool lives on in gateway_disc_test.)
    Page 15 kB -> 5.7 kB gzipped, static RAM 75 kB, status once per second, no
    bulk WebSocket traffic. README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
2026-10-01 gateway_rig_test: fix full-scale channels wrapping to 0 in the 16-bit → byte conversion
    (v + 128) >> 8 gives 256 for v = 65535, which wraps to 0 in a uint8: the
    brightest channels of every scene went black ("colours look wrong").
    Use v >> 8 (65535 → 255). Same overflow indexed past the contrast table in
    the pattern's-own-colours path; that path now has its own 256-entry table.
    Verified at byte level.
    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
2026-10-01 gateway_rig_test: five "Pixel rim" scenes that use the dots on the outer rings against the blended core
    Rim beads · Comet ring · Rim twinkle · Pixel rain · Dial. The outer rings
    (C boards, where the dome shows individual pixels) do discrete pixel-stepped
    things; the core (rings < 17) answers in soft light; outer B rows are a quiet
    hand-over zone. scenes.h gains per-pixel ring index and position-around-ring
    (gRing, gK, RING_N). All five render in well under a millisecond on the host.
    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
2026-10-01 gateway_rig_test: crash-loop safe mode; allocate buffers after the network is up
    - Abnormal resets (panic / WDT / brown-out) are counted in RTC memory; three
    in a row boots SAFE MODE: no render helper, scenes disabled, output off,
    page served and labelled. Counter clears after 90 s healthy or a power
    cycle. Status carries safe/crashes.
    - Our buffers (pixel tables, intent, shading) are now allocated after
    Wi-Fi / Ethernet / web server start so the drivers always get their
    large contiguous blocks first. Boot log prints free heap and the largest
    free block at each stage.
    Claude-Session: https://claude.ai/code/session_016L7YDN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
2026-10-01 gateway_rig_test: retry UDP sends on ENOMEM, show Wi-Fi client count, quieter serial
    Serial showed "endPacket(): could not send data: 12" — lwIP out of pbufs
    mid-burst of 23 Art-Net packets. Retry once after a tick; count only real
    failures. Core debug level 0 so the core no longer prints errors from
    inside the output task over 115200 baud. Boot log names the AP and its IP;
    status and page show the number of connected Wi-Fi clients; a heartbeat
    line on serial every minute (uptime, clients, frames, send errors, heap).
    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
2026-10-01 gateway_rig_test: Pixel-rim scenes back, with watchdogs so the board stays reachable once mounted
    Re-applies the five Pixel-rim scenes, crash-loop safe mode, UDP retry and
    serial instrumentation on top of the known-good 09ab4b9, and adds:
    - Task watchdog (12 s) on the output and housekeeping tasks; both
    unsubscribed during an OTA upload.
    - Web-server self-test every 30 s over lwIP loopback (/ping): once it has
    worked, 3 consecutive failures restart the web server, 6 reboot. Passive
    if loopback never works on a build.
    - Heap watchdog (< 22 kB for 10 s → reboot) and AP watchdog (AP gone for
    15 s → reboot). Our own restarts count toward safe mode.
    - / serves gzip only when the brows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
2026-10-01 gateway_rig_test: revert again to c018073 (known-good) — 1478d9b did not serve the page
    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
2026-10-02 sun_show: standalone show firmware (no web page, OTA kept)
    Olimex ESP32-GATEWAY → Ethernet → PixLite E4-S, 2,417 px. Solar surface and
    Neon fluid take turns for a random 5–10 min each with an 8 s crossfade, both
    through one saturated red/orange palette. Speed and the main parameter of each
    scene wander smoothly (new target every 20–60 s, eased over 15 s; speed is
    integrated so it never jumps). Fixed per-ring brightness curve: centre full →
    taper over rings 1–5 → alternating 50/25/40/20 to the rim. Wi-Fi SUN-DISC is
    hosted for ArduinoOTA only; task WDT 12 s, AP watchdog.
    Claude-Session: https://claude.ai/code/session_016L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
2026-10-02 sun_show: full brightness, W ceiling, hot/dark ring curve
    Master 100 %, power cap 1.00 (this palette + curve peaks ~110 W over the whole
    dome, ~90 W worst case per 500 W wedge PSU). W channel hard-capped at 140 so the
    white die never blows out; R/G/B run to 255, palette's top stops carry more W.
    Ring curve now 100 → 70 45 25 12 5 → 80 6 55 4 … to the rim: literal hot and
    dark spots.
    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
2026-10-02 sun_show: core focus envelope + TEST_MODE
    Scene energy is scaled radially before the palette (full inside 240 mm, easing
    to 0.30 at the rim) so the hot activity concentrates in the diffused centre and
    the pixelated outer rings stay calm and deep red. TEST_MODE 1 compresses timing
    to the preview page's (30 s scenes, 5–10 s wander) for bench testing.
    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
2026-10-02 sun_show: default ring curve = the tuned rig-test curve
    Core rings 0–16 at 2.00 (saturates white-hot), taper 164→28 through the outer B
    rings, C rings at 6–15 with a faint alternation — the curve from the video.
    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
2026-10-02 sun_show: breakthrough — bright features punch through the dark rings
    Per-pixel key on the scene's own energy (before focus/palette): above BREAK_LO
    the ring gain is lifted toward BREAK_GAIN, full at BREAK_HI, and the core-focus
    envelope is bypassed by the same amount. Rays and filaments now run out to the
    rim while the rest of those rings keep the dark shading. Lifts only, never dims.
    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
2026-10-02 sun_show: USB only, tapered flares, gradients instead of blocks
    - Wi-Fi/OTA removed (radio off, ota env gone); core 0 runs only the render helper.
    - Ring gain, core focus and breakthrough now scale the scene ENERGY before the
    palette, followed by a soft shoulder (1 − exp(−1.3·e)), so the ×2.00 core
    shades red → orange → white instead of clipping to one flat block.
    - Palette rebuilt as a continuous 7-stop ramp (R saturates only near 0.9);
    contrast 0.95 for longer tails.
    - Solar surface: radial flare streaks that taper outward and drift out from the
    core, soft shoulder instead of clamp, lower floor so clusters have gaps.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
2026-10-02 sun_show: warmer palette — orange/amber/yellow hot end, W ceiling 90
    Hot end carried by G (0.70 at the top) with little W (0.22, capped at 90) so
    hot spots read yellow-orange instead of blowing out to a cold white on camera.
    Warmth −0.10.
    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
2026-10-02 sun_show: equal-power palette, Neon fluid level restored
    - Palette entries rescaled so total R+G+B+W drive follows 1.2·e^1.3: yellows
    and white-tinged hot spots are no brighter than reds at the same energy,
    and the core keeps a brightness gradient.
    - Per-scene level: Neon fluid ×3.6 (its raw energy is ~4× lower than Solar
    surface, so after the pre-palette pipeline it had sunk to a dim red wash).
    - Show starts on a random scene at power-up.
    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
2026-10-02 sun_show: fast timing by default (30 s scenes, 5–10 s wander)
    The test-mode pace is now the show: people pass through the space and won't
    wait 5–10 min for the other scene. TEST_MODE removed (identical now).
    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
2026-10-02 sun_show: one shared speed, Neon fluid paced to match Solar surface
    Both scenes follow slot 0's wandering speed (never reset mid-show). Per-scene
    `pace` calibrates each clock: Neon fluid's pixels change ~4× faster than Solar
    surface's at the same speed (measured on host), so its pace is 0.25.
    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
2026-10-02 sun_show: relief — W die paints 3D shading
    Scene energy is used as a height map; each pixel's slope (least-squares
    gradient over its 6 nearest pixels, table built at boot) is lit by a light
    circling the dome once a minute. Slopes facing the light get up to 90 of W
    (scaled by how lit the pixel is, W_MAX still applies); slopes facing away are
    darkened 30 %. Every pixel gets its own W value.
    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
2026-10-02 sun_show: relief table in flash, OOM guard, Neon pace 0.45
    - Relief neighbour table generated offline into src/relief_nb.h (flash): no
    58 kB heap allocation and no boot-time O(N²) search.
    - Heap printed after table build; halts with a fast-blinking LED and a serial
    message if any buffer failed to allocate, instead of crashing in a loop.
    - Neon fluid pace 0.25 → 0.45: re-measured on large-scale motion relative to
    each scene's contrast, Neon is ~2.2× faster than Solar surface, not 4×, so
    0.25 left it looking nearly still.
    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
2026-10-02 sun_show: no pink — W only where there's green
    W is clamped to 0.75 × the pixel's G as the last step, so pure reds never get
    white (red + white reads pink). Relief highlights now warm toward amber (+G)
    before adding W.
    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
2026-10-07 Handover: HANDOVER.md + archive/ of earlier gateway_rig_test builds
    HANDOVER.md documents the pixel map, coordinate conventions, the
    ESP32 → Art-Net → PixLite E4-S contract and full PixLite settings,
    the pattern engine (JS + C), dome shading tuning, the experiment log,
    OTA setup, and further improvements, for handing the software to
    another programmer. archive/ holds five snapshots of gateway_rig_test
    from git history (full page with pixel map and testers, dome tuner,
    pre-strip, stripped known-good, pixel-rim + watchdogs attempt).
    Claude-Session: https://claude.ai/code/session_015ZnHKjDf2jiLmwmMcgiCDc
